lego1002/2026_TIRT/OminiBotHV-master/README.md

# OminiBotHV
This is diver about OminiBotHV( manufacturer : Circus Pi  ) , and how to use it.

<p align="center">
  
</p>

----
## Introduction

This repository contains driver , operation manual and communication.

firmware         :  [Bill](https://github.com/CIRCUSPi/OminiBotHV/blob/master/firmware/OminiBotCarStm32f1_v1.0.0.hex)

Communication    :  [OminiBotHV_v1.0.0](https://github.com/CIRCUSPi/OminiBotHV/blob/master/communication/OminibotHV_%E5%BA%95%E5%B1%A4%E9%80%9A%E8%A8%8A%E6%A0%BC%E5%BC%8F%E8%88%87%E5%B0%8F%E8%BB%8A%E9%81%8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)

Example          :  [Mecanum Wheel](https://github.com/CIRCUSPi/OminiBotHV/blob/master/example/OminiBot_HV_Meca.py)

Where to buy     :  [OminiBotHV](https://www.icshop.com.tw/products/368030200586)

----
## More information

You can visit our [official website](http://www.circuspi.com/) and [online shopping platform](https://www.icshop.com.tw/index.php) to search more information about us.

We provide many kinds of tutorial.

* For microcontroller , we have

> 1. [Arduino](http://www.circuspi.com/index.php/category/technical-article/arduino/) .
> 2. [linkit 7697](http://www.circuspi.com/index.php/category/technical-article/linkit/) .
> 3. [micro:bit](http://www.circuspi.com/index.php/category/technical-article/mbitbot-mini/) .

* For AI and Robot , we have 

> 1. [ROS](http://www.circuspi.com/index.php/category/technical-article/ros/).

----

## Development log

* 2023/07/20 (V1.0)
