lego1002/2026_TIRT/docs/OminibotHV_底層通訊格式與小車運動學_V1.0.0.pdf

# OminibotHV 底層通訊與小車運動學

### By Bill

2023/08/25

2

# OminibotHV -通訊封包格式(接收/回授)

3

# OminibotHV – 通訊封包格式定義

### - 數據回授封包格式

– 這裡還有㇐個地方需要注意，設定機器人硬體或是系統的原始資料，皆是浮 點型的資料（float），因為浮點型資料使用串口傳輸不方便，所以這四個資 料在發送之前先將浮點數放大㇐千倍（保留小數點後三位），再將放大後的 浮點數強制轉換成 short 型資料，最後在發送前將 short 型數據拆分成兩個

### 8 位元的數據。相應的，下位機端(STM32)在接收到資料後，需要將接收到

的數據兩個 8 位元資料合併後轉換為 short 型，在縮小㇐千倍來進行單位的 轉換。

### - STM32接收數據封包格式(14 char) – 系統配置

舉例說明 :
馬達方向定義只用到低八位(M4/M3/M2/M1) ，0為正轉，1為反轉。 EX : 0x02，M2反轉，其餘正轉
編碼器方向定義，同馬達方向定義(E4/E3/E2/E1) 。
EX:
4
數據 | Tx[0] | Tx[1] | Tx[2] | Tx[3] | Tx[4] | Tx[5] | Tx[6] | Tx[7] | Tx[8] | Tx[9] | Tx[10] | Tx[11] | Tx[12] | Tx[13]
內容 | 幀頭 0x7B ( ‘{’ ) | 命令 模式 0x23 ( ‘#’ ) | 馬達 方向 定義_ 高八 位 | 編碼 器方 向定 義_低 八位 | 馬達PWM最大 輸出值 | | 馬達PWM最小 輸出值 | | 編碼器PPR (pulse per rotation) | | 預留 | | BBC 校驗 位 | 幀尾 0x7D ( ‘}’ )
字節 大小 | char | char | Short | | Short (1 to 7199) | | Short (1 to 7199) | | Short | | Short (0) | | char | char
陣列 位置 | 0 | 1 | 2 | 3 | 4 | 5 | 6 | 7 | 8 | 9 | 10 | 11 | 12 | 13

# OminibotHV – 通訊封包格式定義(接收)

0 | 0 | 1 | 0

無單位量

### - STM32接收數據封包格式(14 bytes) – 小車尺寸參數配置

5

數據 | Tx[0] | Tx[1] | Tx[2] | Tx[3] | Tx[4] | Tx[5] | Tx[6] | Tx[7] | Tx[8] | Tx[9] | Tx[10] | Tx[11] | Tx[12] | Tx[13]
內容 | 幀頭 0x7B ( ‘{’ ) | 命令 模式 0x24 ( ‘$’ ) | 小車輪距 (Wheel Space) | | 小車軸距 (Axle Space) | | 馬達齒輪比 (Gear Ratio) | | 輪子直徑 (Wheel Diameter) | | 預留 | | BBC 校驗 位 | 幀尾 0x7D ( ‘}’ )
字節 大小 | char | char | Short | | Short | | Short | | Short | | Short | | char | char
陣列 位置 | 0 | 1 | 2 | 3 | 4 | 5 | 6 | 7 | 8 | 9 | 10 | 11 | 12 | 13

# OminibotHV – 通訊封包格式定義(接收)

單位:mm

### - STM32接收數據封包格式(14 bytes) – 小車PID參數配置

6

數據 | Tx[0] | Tx[1] | Tx[2] | Tx[3] | Tx[4] | Tx[5] | Tx[6] | Tx[7] | Tx[8] | Tx[9] | Tx[10] | Tx[11] | Tx[12] | Tx[13]
內容 | 幀頭 0x7B ( ‘{’ ) | 命令 模式 0x40 ( ‘@’ ) | POS_Kp (需要放大100 倍) | | POS_Ki (需要放大100 倍) | | POS_Kd (需要放大100 倍) | | VEL_Kp (需要放大100 倍) | | VEL_Ki (需要放大100 倍) | | BBC 校驗 位 | 幀尾 0x7D ( ‘}’ )
字節 大小 | char | char | Short | | Short | | Short | | Short | | Short | | char | char
陣列 位置 | 0 | 1 | 2 | 3 | 4 | 5 | 6 | 7 | 8 | 9 | 10 | 11 | 12 | 13

# OminibotHV – 通訊封包格式定義(接收)

單位:放大100倍 | 單位:放大100倍 | 單位:放大100倍

- 舉例KUBOT參數設定說明(最大速度只有 0.368 m/s) : – mobptr-> MotorDir=0x00; – mobptr-> EncoderDir =0x02; – mobptr->Divisor_Mode = 4; – mobptr->GearRatio = 139; – mobptr->WheelEncoderPrecision = Divisor_Mode * 973; – mobptr->WheelDiameter = 0.160f; – mobptr->TrackSpacing = 0.240f; – mobptr->AxleSpacing = 0.0f; – mobptr->PWM_DutyCy_Max = 7056; //set pwm max duty cycle to 98%
– mobptr->PWM_DutyCy_Min = 1440; //set pwm min duty cycle to 20% | 7

# OminibotHV – 通訊封包格式定義(接收)

- 舉例KUBOT參數設定說明(最大速度只有 0.368 m/s) : – mobptr->pid_pos[0] = 30.0f; | | //位置控制參數KP
– mobptr->pid_pos[1] = 10.5f; | //位置控制參數KI – mobptr->pid_pos[2] = 0.0f; | //位置控制參數KD
– mobptr->pid_vel[0] = 30.5f; | | //速度控制參數KP
– mobptr->pid_vel[1] = 10.5f; | //速度控制參數KI –

8

# OminibotHV – 通訊封包格式定義(接收)

- 舉例小車系統配置 : – 7B 23 00 02 1B 90 05 A0 03 CD 00 00 BA 7D( { # 0 2 7056 1440 973 0 } )
- 舉例小車尺寸參數配置 : – 7B 24 00 F0 00 00 00 8B 00 A0 00 00 84 7D( { $ 240 0 139 160 0 B } )
- 舉例小車PID參數配置: – 7B 40 0B B8 04 1A 00 00 0B B8 04 1A 3B 7D( { @ 3000 1050 0 3000 1050 B } ) – ( { @ 6000 1050 0 6000 1050 B } )

9

# OminibotHV – 通訊封包格式定義(接收)

### - STM32接收數據封包格式- 運動控制配置

數據 | Tx[0] | Tx[1] | Tx[2] | Tx[3] | Tx[4] | Tx[5] | Tx[6] | Tx[7] | Tx[8] | Tx[9] | Tx[10] | Tx[11] | Tx[12] | Tx[13]
內容 | 幀頭 0x7B ( ‘{’ ) | 命令模 式 ( ‘%’ ‘&’ ) | 控制模 式(停 止/位 置/速 度) | 小車型 別 | X方向 速度或 A馬達 速率_ 高八位 | X方向 速度或 A馬達 速率_ 低八位 | Y方向 速度或 B馬達 速率_ 高八位 | Y方向 速度或 B馬達 速率_ 低八位 | Z方向 速度或 C馬達 速率_ 高八位 | Z方向 速度或 C馬達 速率_ 低八位 | W方向 速度或 D馬達 速率_ 高八位 | W方向 速度或 D馬達 速率_ 低八位 | BBC 校 驗位 | 幀尾 0x7D ( ‘}’ )
字節 大小 | char | char | char | char | short | | short | | short | | short | | char | char
陣列 位置 | 0 | 1 | 2 | 3 | 4 | 5 | 6 | 7 | 8 | 9 | 10 | 11 | 12 | 13

10

# OminibotHV – 通訊封包格式定義(接收)

單位:mm/s或是1000*rad/s

### - STM32接收數據封包格式 – 命令模式選擇(由上層的ROS決定) – 0x23(#) ：小車運動系統配置

– 0x24 ($) ：小車運動學參數配置
– 0x25(%) ：小車速度控制模式(Vx, Vy, Vz) – 0x26 (&) ：小車各馬達獨立控制 with 編碼器(M1, M2, M3, M4) – 0x40 (@) ：小車PID參數
- STM32接收數據封包格式 – 小車型別(由上層的ROS決定) – 0x02：TWODDMOBILE (ex: kubot) – 0x03：OMINIMOBILE (ex: 三輪智慧機器人) – 0x04：MECANUMMOBILE(ex: rosky2, racingrat) – 0x05：FOURWDMOBILE(rosky1)

11

STM32接收數據封包格式 - 控制模式
FORCESTOP ： 0 (強制停止)
POSITIONCTRL ： 1 (位置控制)
VELOCITYCTRL ： 2 (速度控制)

# OminibotHV – 通訊封包格式定義(接收)

- 舉例說明 : – X軸，+200mm/s | ，7B 25 02 05 00 C8 00 00 00 00 00 00 91 7D
– 停止，0mm/s | ，7B 25 02 05 00 00 00 00 00 00 00 00 59 7D
– X軸，-200mm/s | ，7B 25 02 05 FF 38 00 00 00 00 00 00 9E 7D
– 馬達M1，+200mm/s，7B 26 02 05 00 C8 00 00 00 00 00 00 92 7D – 馬達M4，-200mm/s ，7B 26 02 05 00 00 00 00 00 00 FF 38 9D 7D

12

# OminibotHV – 通訊封包格式定義(接收)

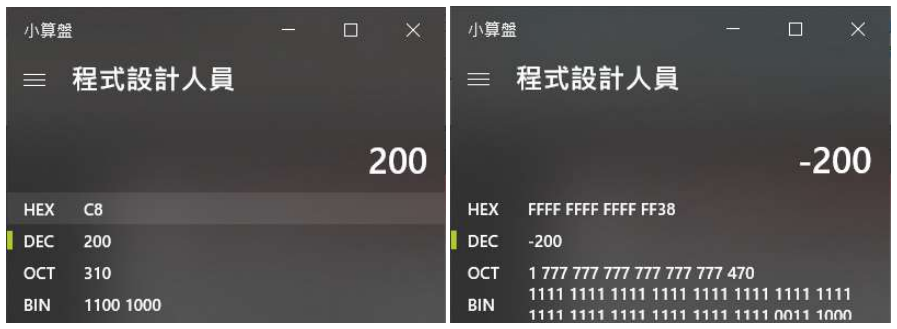
[picture p3: figure]

Block Check Character Calculator

車體ROSKY1做
速度控制

車體ROSKY1做
馬達速度控制

- 舉例說明 : – X軸，+200mm/s | ，7B 25 02 02 00 C8 00 00 00 00 00 00 96 7D
– 停止，0mm/s | ，7B 25 02 02 00 00 00 00 00 00 00 00 5E 7D
– X軸，-200mm/s | ，7B 25 02 02 FF 38 00 00 00 00 00 00 99 7D
– 馬達M1/M2，+100mm/s，7B 26 02 02 00 64 00 64 00 00 00 00 5D 7D – 馬達M1/M2 ，-200mm/s ，7B 26 02 02 FF 38 FF 38 00 00 00 00 5D 7D

13

# OminibotHV – 通訊封包格式定義(接收)

Block Check Character Calculator

KUBOT車體做
線性速度控制

KUBOT馬達做
旋轉速度控制

14

# OminibotHV – 通訊封包格式定義(回授)

### - STM32回授數據封包格式 – 命令模式選擇(由上層的ROS決定) – 0x33(‘3’) ：回授小車運動系統配置

– 0x34 (‘4’) ：回授小車運動學參數配置
– 0x35(‘5’) ：回授小車速度控制模式(Vx, Vy, Vz) – 0x36 (‘6’) ：回授小車各馬達獨立控制 with 編碼器(M1, M2, M3, M4) – 0x50 (‘P’) ：回授小車PID參數

### - STM32回授數據封包格式- 速度控制配置

數據 | Tx[0] | Tx[1] | Tx[2] | Tx[3] | Tx[4] | Tx[5] | Tx[6] | Tx[7] | Tx[8] | Tx[9] | Tx[10] | Tx[11] | Tx[12] | Tx[13]
內容 | 幀頭 0x7B ( ‘{’ ) | 命令模 式 0x35/0 x36 ( ‘5’ ‘6’) | 控制模 式(位 置/速 度/停 止) | 小車型 別 | X方向 速度或 A馬達 速率_ 高八位 | X方向 速度或 A馬達 速率_ 低八位 | Y方向 速度或 B馬達 速率_ 高八位 | Y方向 速度或 B馬達 速率_ 低八位 | Z方向 速度或 C馬達 速率_ 高八位 | Z方向 速度或 C馬達 速率_ 低八位 | W方向 速度或 D馬達 速率_ 高八位 | W方向 速度或 D馬達 速率_ 低八位 | BBC 校 驗位 | 幀尾 0x7D ( ‘}’ )
字節 大小 | char | char | char | char | short | | short | | short | | short | | char | char
陣列 位置 | 0 | 1 | 2 | 3 | 4 | 5 | 6 | 7 | 8 | 9 | 10 | 11 | 12 | 13

15

# OminibotHV – 通訊封包格式定義(回授)

單位:mm/s或是1000*rad/s

### - STM32回授數據封包格式(14 char) – 系統配置

16

數據 | Tx[0] | Tx[1] | Tx[2] | Tx[3] | Tx[4] | Tx[5] | Tx[6] | Tx[7] | Tx[8] | Tx[9] | Tx[10] | Tx[11] | Tx[12] | Tx[13]
內容 | 幀頭 0x7B ( ‘{’ ) | 命令 模式 0x33 ( ‘3’ ) | 馬達 方向 定義_ 高八 位 | 編碼 器方 向定 義_低 八位 | 馬達PWM最大 輸出值 | | 馬達PWM最小 輸出值 | | 編碼器PPR (pulse per rotation) | | 預留 | | BBC 校驗 位 | 幀尾 0x7D ( ‘}’ )
字節 大小 | char | char | Short | | Short (max to 7199) | | Short (min to 720) | | Short | | Short (0) | | char | char
陣列 位置 | 0 | 1 | 2 | 3 | 4 | 5 | 6 | 7 | 8 | 9 | 10 | 11 | 12 | 13

# OminibotHV – 通訊封包格式定義(回授)

0 | 0 | 1 | 0

無單位量

### - STM32回授數據封包格式(14 bytes) – 小車尺寸參數配置

17

數據 | Tx[0] | Tx[1] | Tx[2] | Tx[3] | Tx[4] | Tx[5] | Tx[6] | Tx[7] | Tx[8] | Tx[9] | Tx[10] | Tx[11] | Tx[12] | Tx[13]
內容 | 幀頭 0x7B ( ‘{’ ) | 命令 模式 0x34 ( ‘4’ ) | 小車輪距 (Wheel Space) | | 小車軸距 (Axle Space) | | 馬達齒輪比 (Gear Ratio) | | 輪子直徑 (Wheel Diameter) | | 預留 | | BBC 校驗 位 | 幀尾 0x7D ( ‘}’ )
字節 大小 | char | char | Short | | Short | | Short | | Short | | Short | | char | char
陣列 位置 | 0 | 1 | 2 | 3 | 4 | 5 | 6 | 7 | 8 | 9 | 10 | 11 | 12 | 13

# OminibotHV – 通訊封包格式定義(回授)

單位:mm

### - STM32回授數據封包格式(14 bytes) – 小車PID參數配置

18

數據 | Tx[0] | Tx[1] | Tx[2] | Tx[3] | Tx[4] | Tx[5] | Tx[6] | Tx[7] | Tx[8] | Tx[9] | Tx[10] | Tx[11] | Tx[12] | Tx[13]
內容 | 幀頭 0x7B ( ‘{’ ) | 命令 模式 0x50 ( ‘P’ ) | POS_Kp (需要放大100 倍) | | POS_Ki (需要放大100 倍) | | POS_Kd (需要放大100 倍) | | VEL_Kp (需要放大100 倍) | | VEL_Ki (需要放大100 倍) | | BBC 校驗 位 | 幀尾 0x7D ( ‘}’ )
字節 大小 | char | char | Short | | Short | | Short | | Short | | Short | | char | char
陣列 位置 | 0 | 1 | 2 | 3 | 4 | 5 | 6 | 7 | 8 | 9 | 10 | 11 | 12 | 13

# OminibotHV – 通訊封包格式定義(回授)

單位:放大100倍 | 單位:放大100倍 | 單位:放大100倍

- 舉例讀回小車系統配置 : – 7B 33 00 00 00 00 00 00 00 00 00 00 48 7D( { 3 0 0 0 0 0 B } )
- 舉例讀回小車尺寸參數配置 : – 7B 34 00 00 00 00 00 00 00 00 00 00 4F 7D( { 4 0 0 0 0 0 B } )
- 舉例讀回小車PID參數配置: – 7B 50 00 00 00 00 00 00 00 00 00 00 2B 7D( { P 0 0 0 0 0 B } )

19

# OminibotHV – 通訊封包格式定義(回授)

數據 | Tx[0] | Tx[1] | Tx[2] | Tx[3] | Tx[4] | Tx[5] | Tx[6] | Tx[7] | Tx[8] | Tx[9] | Tx[10] | Tx[11] | Tx[12] | Tx[13]
內容 | 幀頭 0x7B | 預留 | X方向 速度_ 高八位 | X方向 速度_ 低八位 | Y方向 速度_ 高八位 | Y方向 速度_ 低八位 | Z方向 速度_ 高八位 | Z方向 速度_ 低八位 | X軸加 速度_ 高八位 | X軸加 速度_ 低八位 | Y軸加 速度_ 高八位 | Y軸加 速度_ 低八位 | Z軸加 速度_ 高八位 | Z軸加 速度_ 低八位
字節 大小 | char | char | short | | short | | short | | short | | short | | short
陣列 位置 | 0 | 1 | 2 | 3 | 4 | 5 | 6 | 7 | 8 | 9 | 10 | 11 | 12 | 13

### - STM32回授數據封包格式(mm/s & 放大1000)

20

# OminibotHV – 通訊封包格式定義(回授)

### - STM32回授數據封包格式(放大1000)

21

# OminibotHV – 通訊封包格式定義(回授)

數據 | Tx[14] | Tx[15] | Tx[16] | Tx[17] | Tx[18] | Tx[19] | Tx[20] | Tx[21] | Tx[22] | Tx[23] | Tx[24] | Tx[25] | Tx[26] | Tx[27]
內容 | X方向 角速度 高八位 | X方向 角速度 低八位 | Y方向 角速度 高八位 | Y方向 角速度 低八位 | Z方向 角速度 高八位 | Z方向 角速度 低八位 | 四元數 W方向 高八位 | 四元數 W方向 低八位 | 四元數 X方向 高八位 | 四元數 X方向 低八位 | 四元數 Y方向 高八位 | 四元數 Y方向 低八位 | 四元數 Z方向 高八位 | 四元數 Z方向 低八位
字節 大小 | short | | short | | short | | short | | short | | short | | short
陣列 位置 | 14 | 15 | 16 | 17 | 18 | 19 | 20 | 21 | 22 | 23 | 24 | 25 | 26 | 27

- STM32回授數據封包格式

– 這裡還有㇐個地方需要注意，機器人 XYZ 三軸線性速度、加速度 計、角速度計、四元數方位值以及電池電壓的原始資料是浮點型的 資料（float），因為浮點型資料使用串口傳輸不方便，所以這四 個資料在發送之前先將浮點數放大㇐千倍（保留小數點後三位）， 再將放大後的浮點數強制轉換成 short 型資料，最後在發送前將 short 型數據拆分成兩個 8 位元的數據。相應的，上位機端在接收 到資料後，需要將接收到的數據兩個 8 位元資料合併後轉換為 short 型，在縮小㇐千倍來進行單位的轉換。

22

# OminibotHV – 通訊封包格式定義(回授)

數據 | Tx[28] | Tx[29] | Tx[30] | Tx[31]
內容 | 電壓_ 高八位 | 電壓_ 低八位 | BBC 校驗 位 | 幀尾 0x7D
字節 大小 | short | | char | char
陣列 位置 | 28 | 29 | 30 | 31

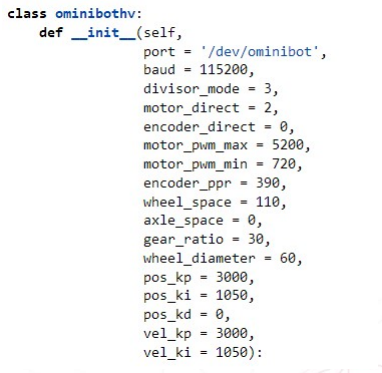
[picture p4: figure]
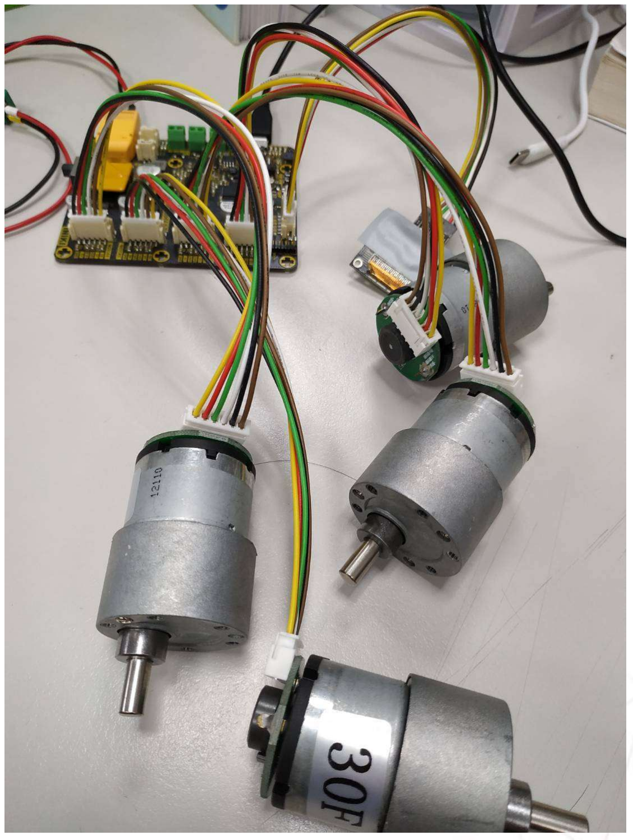
[picture p5: figure]

### - 確認硬體接線和開關

– PWR_ON(開啟電源) – MODE_ON(OLED才會顯示)

### - 參數設定

– 四輪小車系統配置

### - 觀察OLED

– 四輪小車運動控制

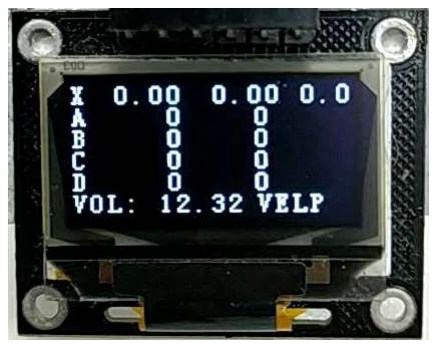
[picture p6: figure]

23

# OminibotHV板 – QC功能測試範例程式(4輪小車)

預設+12V

24

# OminibotHV板 –QC功能測試範例程式(4輪小車)

### - 第㇐步，依序執行四輪小車系統配置 :

1) 7B 23 05 00 10 00 02 D0 01 86 00 00 18 7D( { # 0 2 4096 720 390 0 } )
2) 7B 24 00 F0 00 00 00 8B 00 A0 00 00 84 7D( { $ 240 0 139 160 0 B } )
3) 7B 40 0B B8 04 1A 00 00 0B B8 04 1A 3B 7D( { @ 3000 1050 0 3000 1050 B } )

### - 第二步，四輪小車運動控制 :

1) X軸，+200mm/s | ，7B 25 02 05 00 C8 00 00 00 00 00 00 91 7D
2) 停止，0mm/s | ，7B 25 02 05 00 00 00 00 00 00 00 00 59 7D
3) X軸，-200mm/s | ，7B 25 02 05 FF 38 00 00 00 00 00 00 9E 7D
4) 馬達M1，+200mm/s，7B 26 02 05 00 C8 00 00 00 00 00 00 92 7D
5) 馬達M2，+200mm/s，7B 26 02 05 00 00 00 C8 00 00 00 00 92 7D
6) 馬達M3，+200mm/s，7B 26 02 05 00 00 00 00 00 C8 00 00 92 7D
7) 馬達M4，+200mm/s，7B 26 02 05 00 00 00 00 00 00 00 C8 92 7D

25

# OminibotHV -FLASH讀寫控制

### - FLASH存儲起始位址 : 0x0801FC00

26

# Stm32範例程式(九) – FLASH讀寫控制

數 據 | [0] | [1] | [2] | [3] | [4] | [5] | [6] | [7] | [8] | [9] | [10] | [11]
內 容 | 小車 型別 (1~4) | 控制 模式 (1~2) | 位置 PID_P 值 | 位置 PID_I 值 | 位置 PID_ D值 | 速度 PID_P 值 | 速度 PID_I 值 | 速度 PID_ D值 | PWM _最 大值 | PWM _最 小值 | 預留 | 預留
字 節 大 小 | word | word | word | word | word | word | word | word | word | word | word | word
陣 列 位 置 | 0 | 1 | 2 | 3 | 4 | 5 | 6 | 7 | 8 | 9 | 10 | 11

27

# OminibotHV -小車正/逆運動學

# OminibotHV - 小車正/逆運動學(兩輪差速)

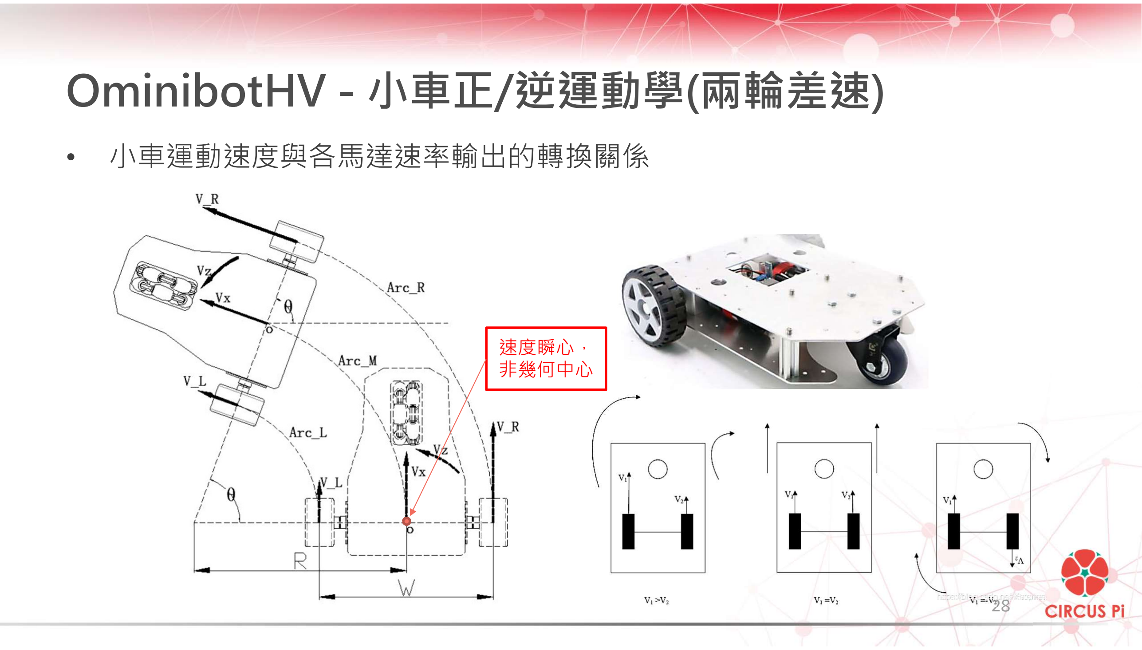
[picture p7: page 28]

### - 小車運動速度與各馬達速率輸出的轉換關係

28

速度瞬心，
非幾何中心

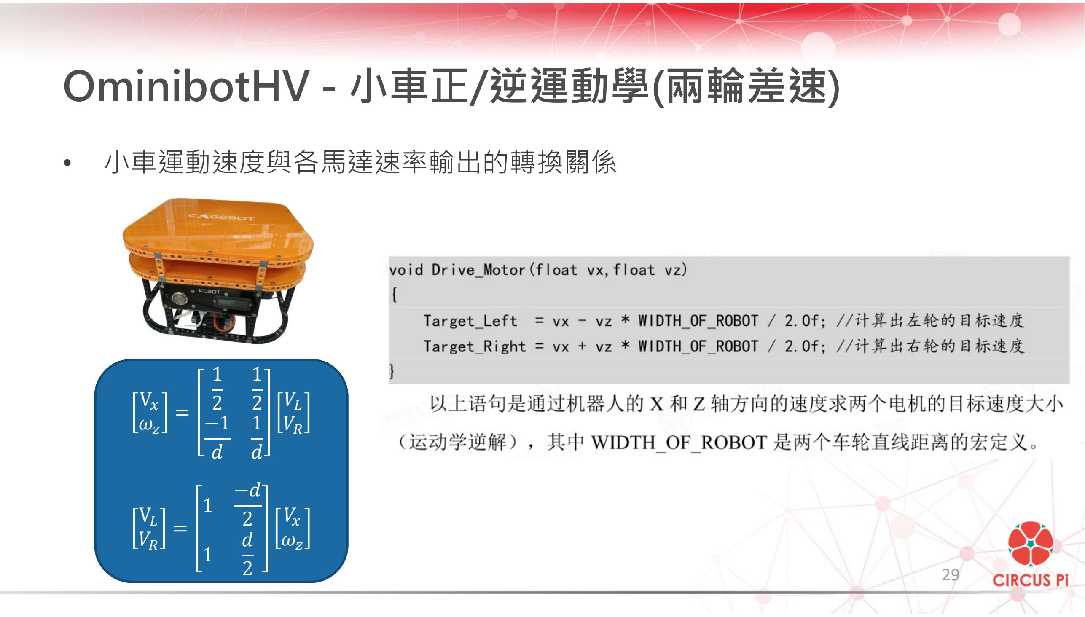
[picture p8: figure]
• 小車運動速度與各馬達速率輸出的轉換關係; OminibotHV - 小車正/逆運動學(兩輪差速)

# OminibotHV - 小車正/逆運動學(四輪差速)

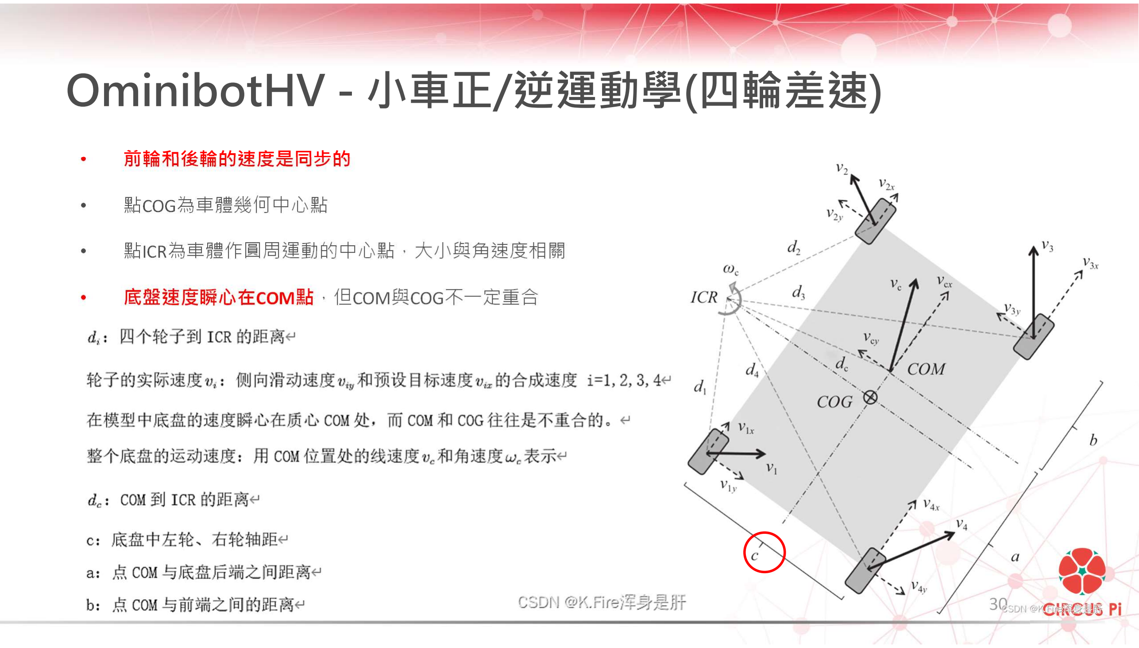
[picture p9: page 30]

- 前輪和後輪的速度是同步的
- 點COG為車體幾何中心點
- 點ICR為車體作圓周運動的中心點，大小與角速度相關
- 底盤速度瞬心在COM點，但COM與COG不㇐定重合

30

# OminibotHV - 小車正/逆運動學(四輪差速)

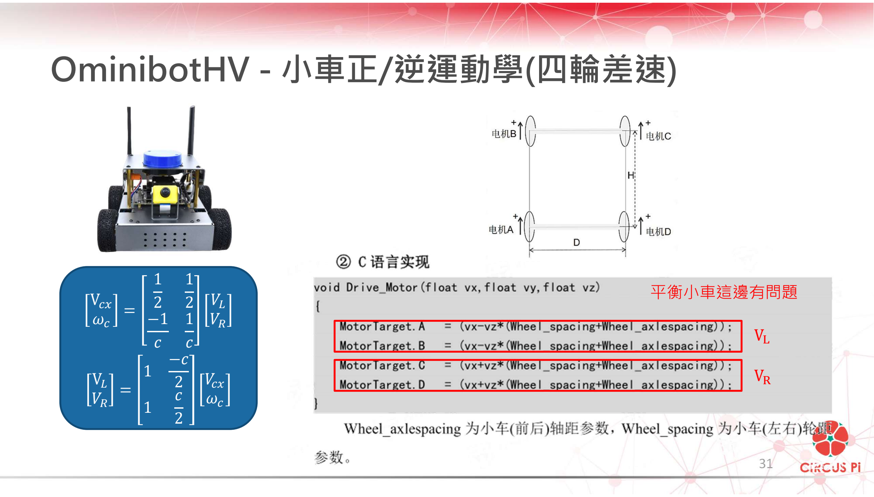
[picture p10: page 31]

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
平衡小車這邊有問題

# OminibotHV - 小車正/逆運動學(麥克拉姆輪)

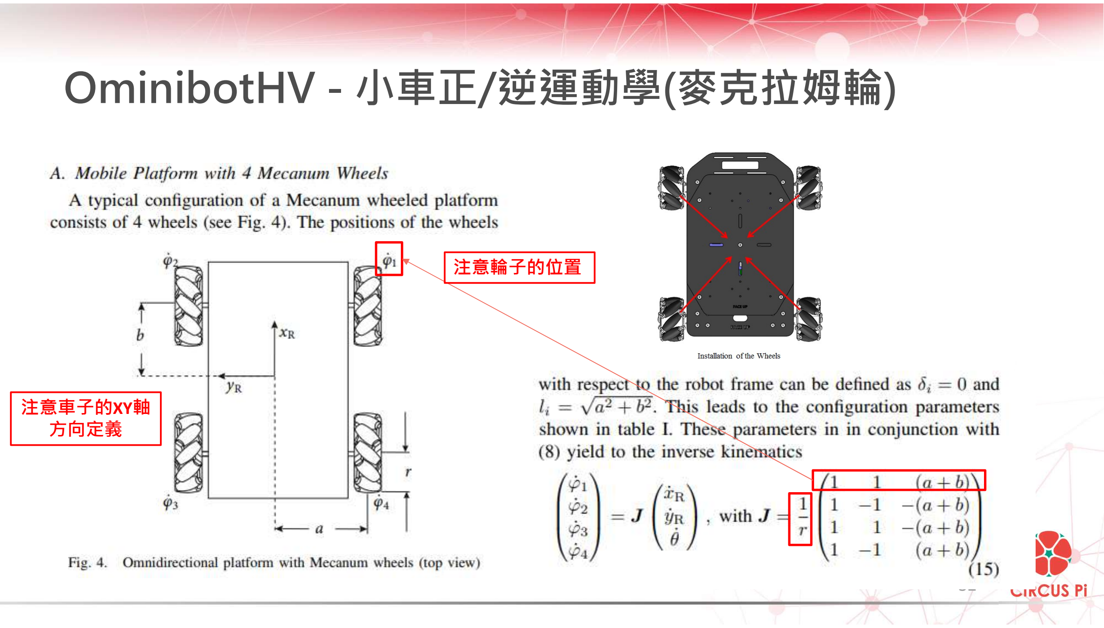
[picture p11: page 32]

32

注意輪子的位置

注意車子的XY軸
方向定義

# OminibotHV - 小車正/逆運動學(麥克拉姆輪)

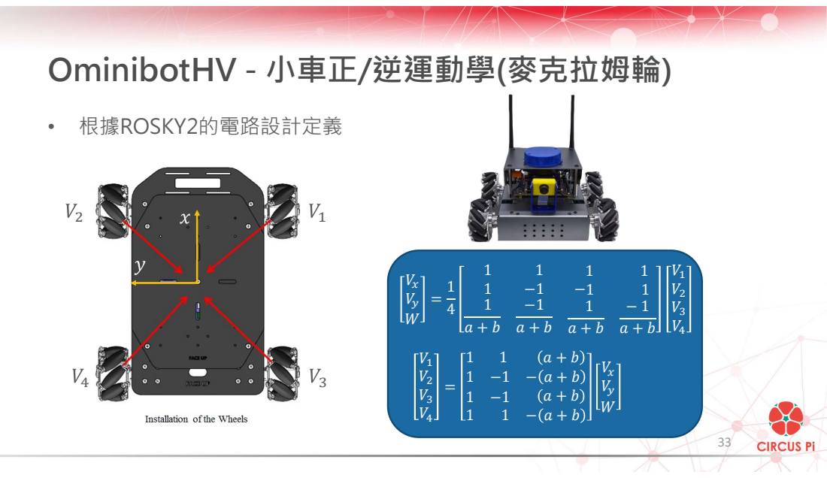
[picture p12: page 33]
• 根據ROSKY2的電路設計定義

# OminibotHV - 小車正/逆運動學(全向輪)

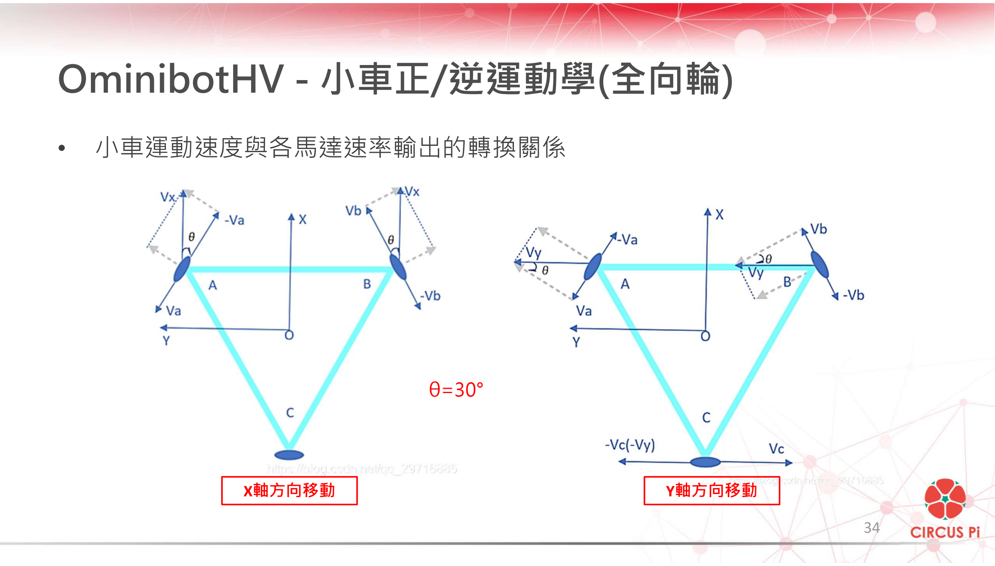
[picture p13: page 34]

### - 小車運動速度與各馬達速率輸出的轉換關係

34

X軸方向移動 | Y軸方向移動

θ=30°

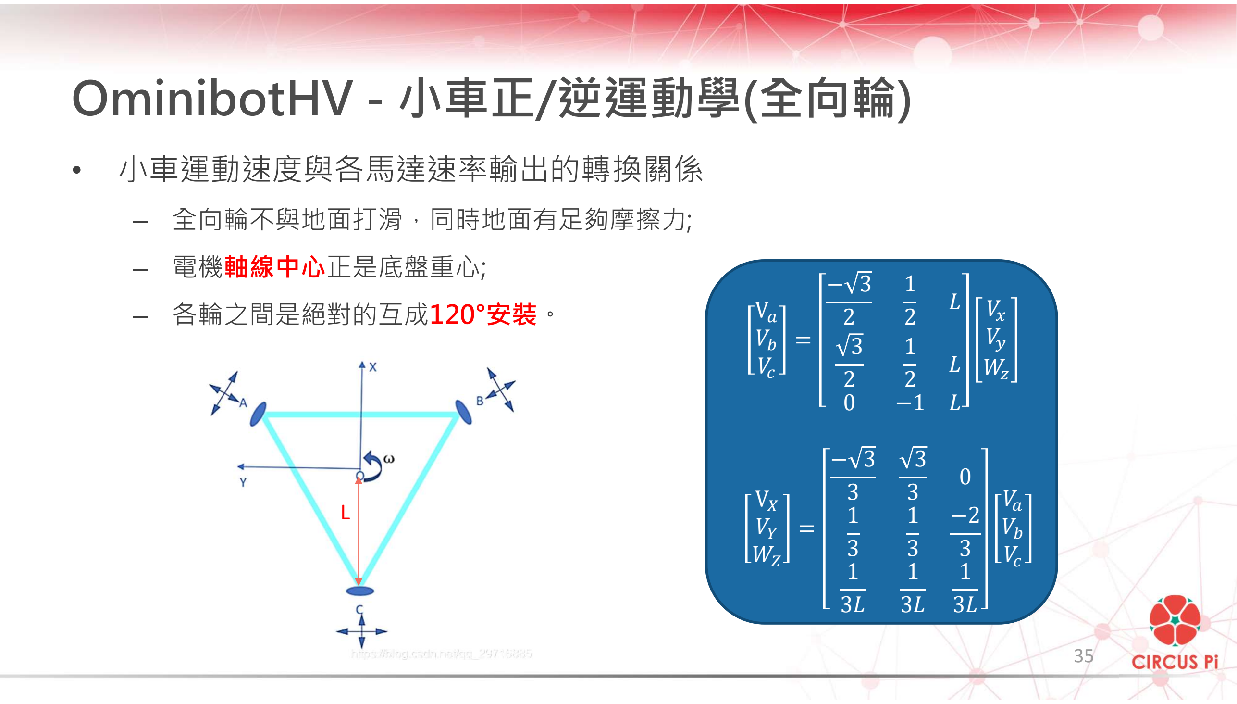
[picture p14: figure]
• 小車運動速度與各馬達速率輸出的轉換關係; OminibotHV - 小車正/逆運動學(全向輪)

– 全向輪不與地面打滑，同時地面有足夠摩擦力; – 電機軸線中心正是底盤重心; – 各輪之間是絕對的互成120°安裝。
