lego1002/2026_TIRT/notes/README.md

# 文件索引

## 比賽

| 文件 | 內容 |
|---|---|
| [比賽紀錄](../race_logs/2026-11-07/README.md) | 2026-11-07 的時間軸、數據和判斷 |
| [比賽現場解題手冊](../race_logs/2026-11-07/比賽現場解題手冊.md) | 遇到問題時照著做的步驟 |
| [比賽規則](../docs/2026TIRT-迷宮機器人挑戰賽.pdf) | 官方規則 PDF |

## 建圖與導航

| 文件 | 內容 |
|---|---|
| [SLAM_learning_note.md](SLAM_learning_note.md) | SLAM 入門、實測問題與校正步驟 |
| [nav2_tuning.md](nav2_tuning.md) | Nav2 症狀對照和調參方法 |
| [nav_runs/](nav_runs/) | 2026-10-10 兩趟導航的錄檔 |

## 操作與連線

| 文件 | 內容 |
|---|---|
| [command_note.md](command_note.md) | 建圖流程指令小抄（雙機模式時期） |
| [雙機RViz連線.md](雙機RViz連線.md) | 雙機模式的完整操作手冊 |
| [networkplan.md](networkplan.md) | 比賽現場自帶 WiFi 的規劃 |
| [0721_net_issue_plan.md](0721_net_issue_plan.md) | 掉 scan 問題的網路除錯紀錄 |

## 機構與硬體

| 文件 | 內容 |
|---|---|
| [urdf閱讀方法.md](urdf閱讀方法.md) | URDF 檢視方法和待辦 |
| [控制板通訊協定](../docs/OminibotHV_底層通訊格式與小車運動學_V1.0.0.pdf) | OminiBotHV 序列埠格式和運動學 |

## 模擬

| 文件 | 內容 |
|---|---|
| [sim/README.md](../sim/README.md) | 模擬器使用說明 |
| [sim/faults.md](../sim/faults.md) | 重現這台車實際發生過的故障 |

## 實測資料

| 路徑 | 內容 |
|---|---|
| [field_data/2026-07_odom_straight/](field_data/2026-07_odom_straight/) | 2026 年 7 月直線里程測試 log |

> 較舊的筆記可能描述當時的做法。目前的操作方式以根目錄 [README](../README.md) 為準，技術細節以 [CLAUDE.md](../CLAUDE.md) 為準。
