lego1002/2026_TIRT/race_logs/2026-11-07/README.md

# 2026 TIRT 比賽紀錄（2026-11-07）

這個資料夾保存比賽當天 10:40～11:00 的指令、系統訊息和分析，方便之後回頭研究。

- **現場遇到問題怎麼辦：** 看 [`比賽現場解題手冊.md`](比賽現場解題手冊.md)
- **只想看發生順序：** 看下面的「時間軸」，完整版在 [`timeline_auto.txt`](timeline_auto.txt)

## 一句話結論

場上 3 個導航目標都沒有到達。地圖、供電和序列埠看起來正常；主要症狀是車子跑到中途開始**反覆左右移動**，只前進一點點。
**根本原因還沒有定論**，因為這次沒有錄到車子的位置和速度指令。

## 操作者的現場觀察

這些是操作者親眼看到的，log 裡看不出來，所以記在這裡：

- 用 `a/d` 原地轉向，地圖會飄；不用 `a/d`，就算邊打滑邊建圖，IMU 也抓得準，牆不會跑掉。
- 場地本身會打滑。
- 車子跑到中途開始抖，但 Nav2 有規劃出路徑，也沒有吃到安全區。
- 賽後回想：車子只跑一點點，**輪子沒有在空轉，而是反覆左右移動**。
- 導航前定位已經顯示 OK。
- 在租屋處建圖都比今天慢，導航速度相同，卻跑得很順。
- 在租屋處，比賽和房間兩種安全圈參數都用過，差別只有撞牆多寡。
- 最嚴重的問題：車子走不到三個導航點就開始出問題。

## 時間軸

選單順序來自 `operator/menu_session.txt`，時間來自 ROS log。

| 時間 | 操作 | 系統回應 |
|---|---|---|
| 10:40 | 選單 `1` 建圖、`2` 遙控 | 線速度在 0.16～0.22 m/s 之間調整 |
| 10:44:46 | 選單 `0` 全關 | **第 1 次建圖沒有存圖** |
| 10:45 | 選單 `1`、`2` | |
| 10:47:52 | 選單 `0` 全關 | **第 2 次建圖沒有存圖** |
| 10:49 | 選單 `1`、`2`、`2` | 轉向速度從 0.8 降到 0.58 rad/s |
| 10:53:21 | 選單 `3` 存圖 | 地圖 `rzce` 存檔成功 |
| 10:53:28 | 選單 `0` 全關 | |
| 10:54:13 | 選單 `4` 導航（`rzce`） | 啟動時一次序列埠警告（8.5%），之後沒再出現 |
| 10:55:11 | 送出 2 個航點，第一個是 (3.05, -1.95) | 開始走 |
| 10:55:32 | 手動取消目標 | `Goal canceled` |
| 10:56:00 | 選單 `4` 重開導航，底盤沒關 | 舊導航 5 秒內沒結束，被強制關閉 |
| 10:56:20 | 新導航啟動中 | **卡住 64 秒**，一直沒有載入節點 |
| 10:57:24 | 選單 `0` 全關 | `Abandoning wait for ... load_node` |
| 10:57:46 | 選單 `4` 導航（`rzce`） | 正常啟動 |
| 10:58:07 | 目標 (3.16, -2.05) | 開始走 |
| 10:58:32 | | 第 1 次 `Failed to make progress` |
| 10:58:40 | 換目標 (2.77, -4.08) | 此時只走了約 0.67 m（AMCL 位置） |
| 10:58:47～10:59:17 | | 再 3 次 `Failed to make progress` |
| 10:59:17 | | 自動原地轉 90° 救援 |
| 10:59:30～10:59:50 | | 規劃失敗 10 次；後退救援報 `Collision Ahead`；再轉一次 90° |
| 10:59:50 | | `Goal failed` |
| 11:00:44 | 選單 `0` 全關 | 光達馬達正常停止 |

## 數據比較

導航參數從 2026-10-27 之後沒有改過。

| | 11/2＋11/6（租屋處） | 11/7（比賽） |
|---|---|---|
| 到達目標 | 15 / 15 | 0 / 3 |
| `Failed to make progress` | 0 次 | 4 次 |
| 單趟距離 | 最遠 2.63 m | 3.8～4.3 m |
| 地圖可走面積 | 約 4 m²（11/6 的圖） | 約 14 m² |

## 判斷

### 看起來正常

- **地圖 `rzce`：** 牆大致互相垂直，沒有彎掉，大小約 4.0×4.1 m；部分內牆有雙線。
- **供電：** 賽後 `get_throttled` 為 `0x0`，代表這次開機以來沒有欠壓或過熱旗標。
- **序列埠：** 只有一次警告，`uart overrun=0`，也沒有 `feedback gap` 警告。
- **CPU：** 控制迴圈只漏了 2 次。
- **地圖幾何：** 3 個目標在靜態地圖上都走得到，最窄處約 31 公分寬。

### 推測（尚未驗證）

| 嫌疑 | 根據 | 還缺什麼 |
|---|---|---|
| 控制器左右修正過頭 | 反覆左右移動，移動範圍若沒超過 10 cm，就正好符合連續 `Failed to make progress`；`PathDist` 權重 32，路徑每秒更新一次 | 錄 `/cmd_vel`，看橫移方向是否來回翻轉 |
| 定位左右跳動，控制器跟著追 | 場地大、牆遠，和在家不同；AMCL 每 5 cm 就更新一次，這條線在 `notes/nav2_tuning.md` 也還沒查 | 同時錄 AMCL 位置和里程，比對跳動 |
| 橫移在滑的地面上衝過頭 | 在家量過橫移 1 m 實際走 1.074 m；同參數在家不會左右來回 | 改小橫移速度或加減速重跑 |
| 輪速頂到上限 | 合成需求最高約 0.54 m/s，實測上限約 0.44 m/s | 同一套參數在家沒抖，所以嫌疑較小 |
| 原地轉時光達掃描變形，地圖和定位變差 | 0.72 rad/s 時，掃一圈車頭轉約 4°，3 m 外偏約 21 cm；和不用 a/d 就穩定的觀察相符 | 錄掃描資料比對 |
| 規劃失敗是因為車太貼牆或定位偏掉 | 靜態地圖走得到，後退時卻報 `Collision Ahead` | 失敗當下的車子位置 |

安全圈不太像是抖動的主因：操作者在家兩種都用過，差別只有撞牆多寡。

### 已確認的軟體問題

底盤開著、在筆電 RViz 模式下原地重開導航，曾卡住 64 秒。全關再開就恢復。卡住的原因還沒查。

## 這份紀錄缺什麼

下次要分析得更準，最缺的是前兩項：

1. **車子位置和速度指令：** 這次沒有開 `tools/nav_record.py`。
2. **實際畫面：** 沒有拍車子的影片，也沒有 RViz 截圖，左右移動的幅度和頻率只能靠回憶。
3. **視窗畫面：** `tirt` tmux 各視窗的輸出沒有另外存，只留下 ROS log。
4. **正式成績：** 這裡沒有記錄名次和官方判定。

## 資料夾內容

| 路徑 | 內容 |
|---|---|
| `timeline_auto.txt` | 從 ROS log 抽出的重要事件，依時間排序 |
| `operator/menu_session.txt` | 選單畫面完整紀錄（按了什麼、看到什麼） |
| `operator/shell_commands.txt` | 選單送進 tmux 的指令（shell 歷史沒有時間戳） |
| `ros_log/` | 當天所有 ROS 節點和 launch 的原始 log |
| `params/` | 比賽版設定檔；`resolved_at_race/` 是實際載入的參數 |
| `map/` | 比賽地圖 `rzce` 和放大 3 倍的圖片 |
| `code/` | 當時的 commit，以及尚未 commit 的 teleop 緩加速修改 |
| `system/` | 核心和 OLED 服務的 log、賽後電源狀態 |

### 讀 log 時要注意

- `system/kernel_and_oled.txt` 開頭的日期是 10-12，因為 Pi 沒有電池時鐘，開機時時間還沒校正。10:39 左右校正之後才準。
- 這個倉庫是公開的，所以 MAC、區網和 Tailscale IP、光達序號已經遮掉，也沒有放入網路服務的系統 log。除此之外，ROS log 內容保持原樣。
