lego1002/2026_TIRT/THIRD_PARTY_NOTICES.md

# 第三方內容說明

根目錄的 [`LICENSE`](LICENSE)（BSD-3-Clause）適用於本專案自己撰寫的內容。下列內容屬於各自的權利人，或來源的授權尚未確認，**不在** BSD-3-Clause 的授權範圍內。

| 路徑 | 來源 | 狀態 |
|---|---|---|
| `OminiBotHV-master/` | CircusPi 的 OminiBotHV 範例、韌體和文件 | 未附授權聲明 |
| `ominibot_driver/ominibot_driver/ominibot_hv.py` | 通訊協定類別整理自上述廠商範例，之後另有修改 | 來自廠商範例的部分，授權尚未確認 |
| `docs/2026TIRT-迷宮機器人挑戰賽.pdf` | 比賽主辦單位 | 屬於主辦單位 |
| `docs/OminibotHV_底層通訊格式與小車運動學_V1.0.0.pdf` | CircusPi | 屬於廠商 |
| `CAD_files/step/Lego Technic Beam - 6898072/` | Thingiverse 作者 chriscummings100 | 見該資料夾的 `LICENSE.txt` |
| `CAD_files/` 裡的其他市售零件參考模型（麥克納姆輪、N20 馬達、Raspberry Pi、光達等） | 各自的作者或廠商 | 來源和授權尚未逐一確認 |
| `car_assemble_description/meshes/` | 由包含上述零件的組合件匯出 | 其中的第三方幾何依原來源為準 |
| `car_assemble_description/rviz/view_nav2.rviz` | 修改自 `nav2_bringup` 的 `nav2_default_view.rviz` | 依 Nav2 上游授權 |
| `config/nav2_params.yaml` | 以 `nav2_bringup` 的預設參數為基礎 | 依 Nav2 上游授權 |
| `config/mapper_params_online_async.yaml` | 以 `slam_toolbox` 的預設參數為基礎 | 依 slam_toolbox 上游授權 |

如果你是上述內容的權利人，發現標示有誤，或希望移除，請開 issue 告知。
