lego1002/2026_TIRT/docs/螢幕快照 2026-07-21 22-19-02.png

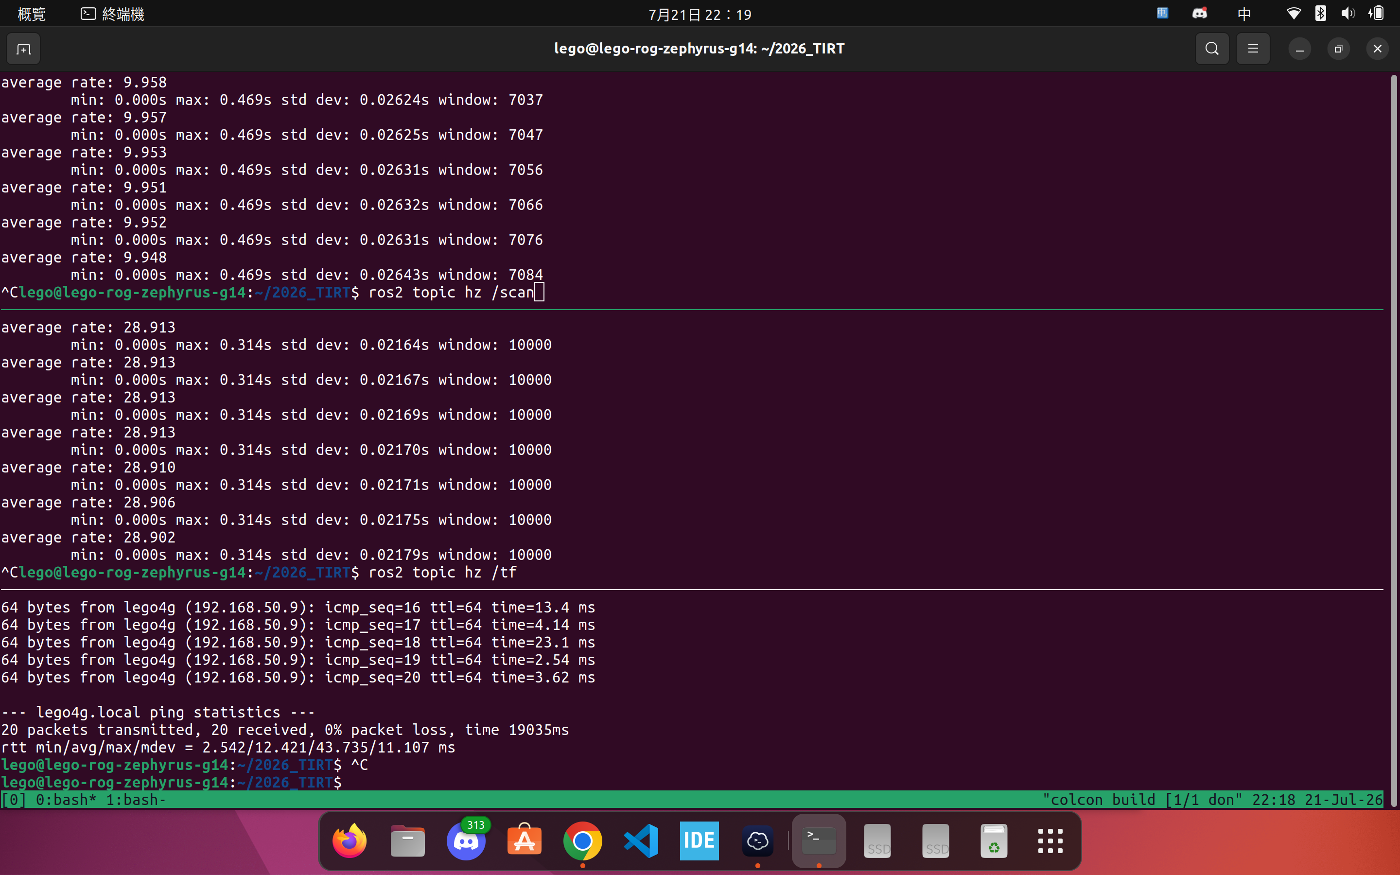
docs/螢幕快照 2026-07-21 22-19-02.png
