lego1002/2026_TIRT/docs/螢幕快照 2026-09-12 00-44-25.png

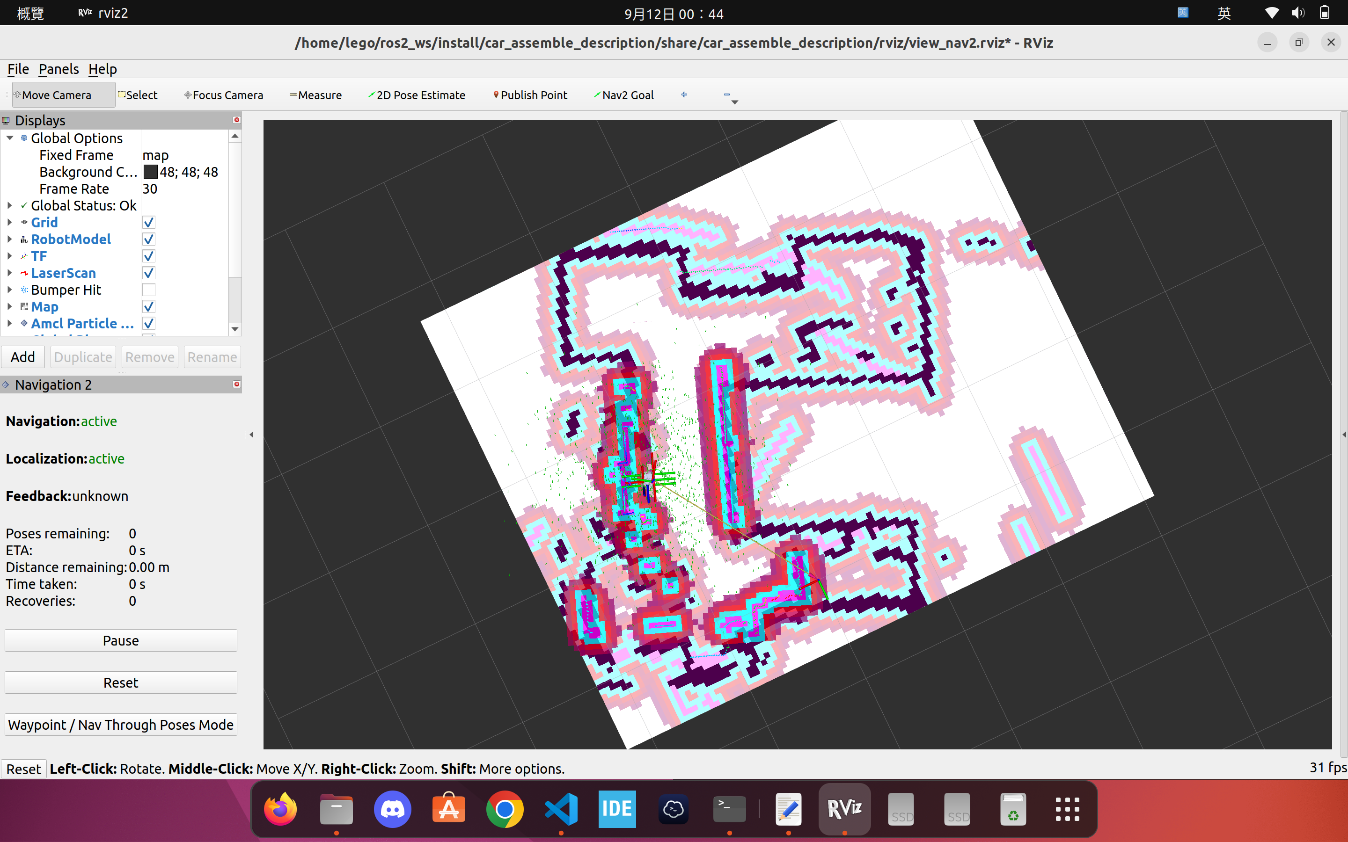
docs/螢幕快照 2026-09-12 00-44-25.png
