lego1002/2026_TIRT/docs/螢幕快照 2026-10-10 13-58-24.png

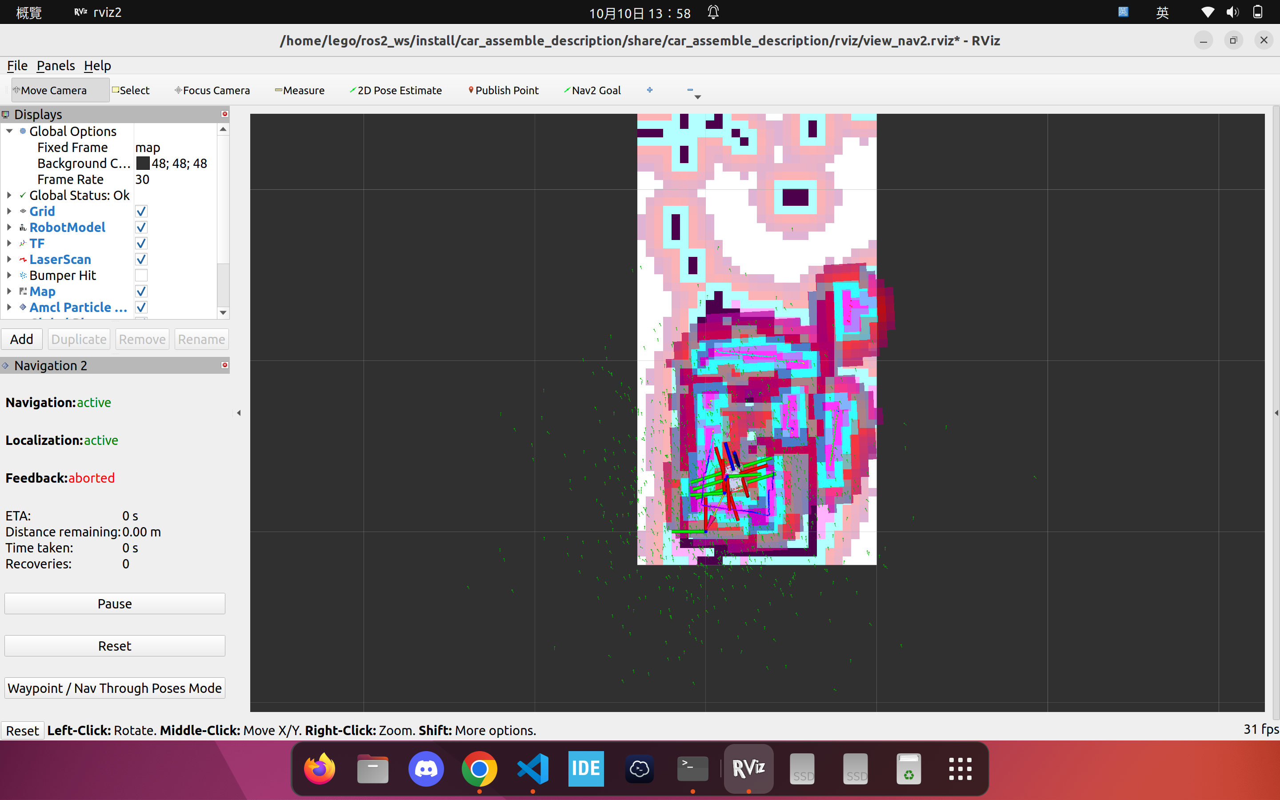
docs/螢幕快照 2026-10-10 13-58-24.png
