lego1002/2026_TIRT/docs/螢幕擷取畫面 2026-10-26 162925.png

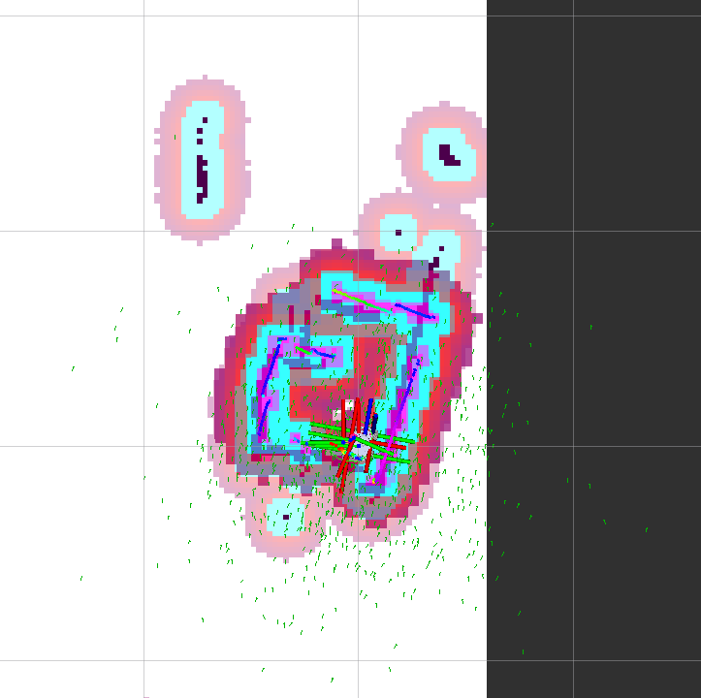
docs/螢幕擷取畫面 2026-10-26 162925.png
