lego1002/2026_TIRT/OminiBotHV-master/image/OminiBotHV.jpg

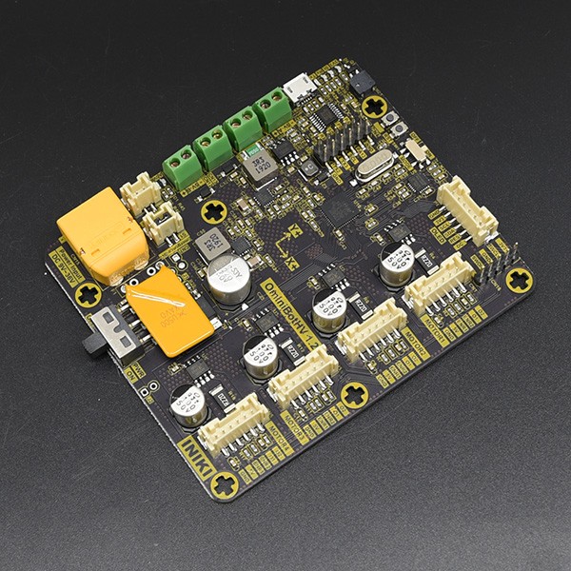
OminiBotHV-master/image/OminiBotHV.jpg
