lego1002/2026_TIRT/race_logs/2026-11-07/map/rzce_x3.png

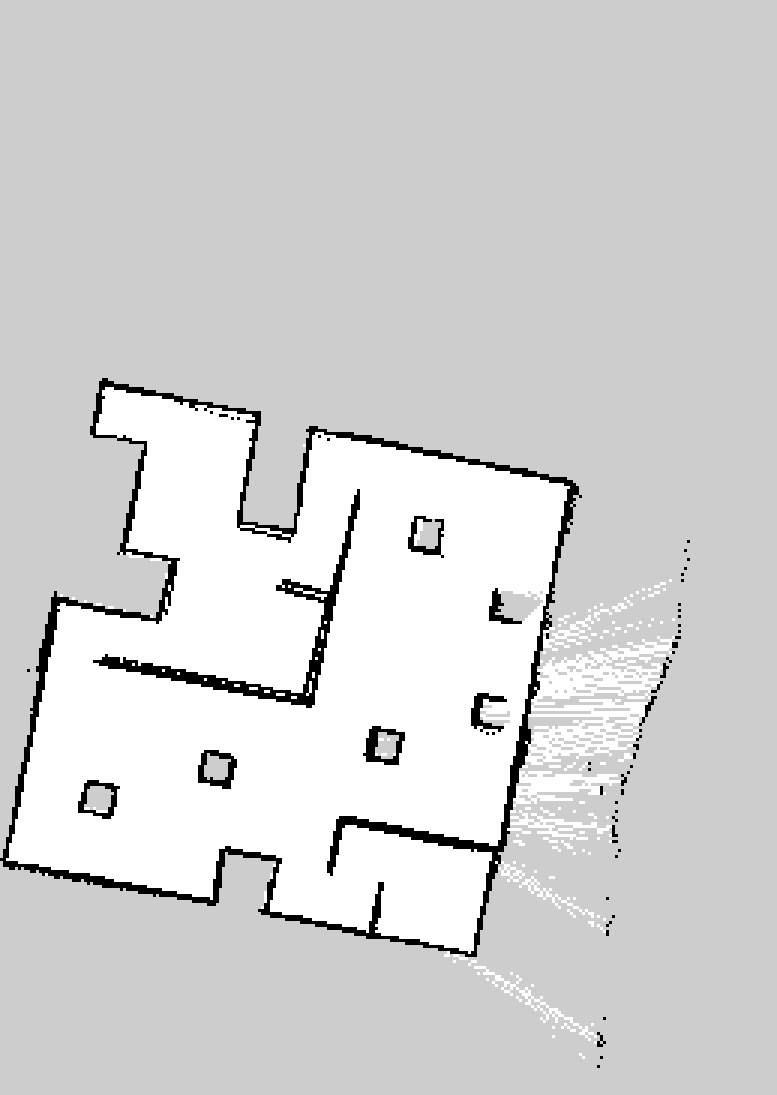
race_logs/2026-11-07/map/rzce_x3.png
