lego1002/2026_TIRT/CAD_files/step/Lego_Fram_57.stp

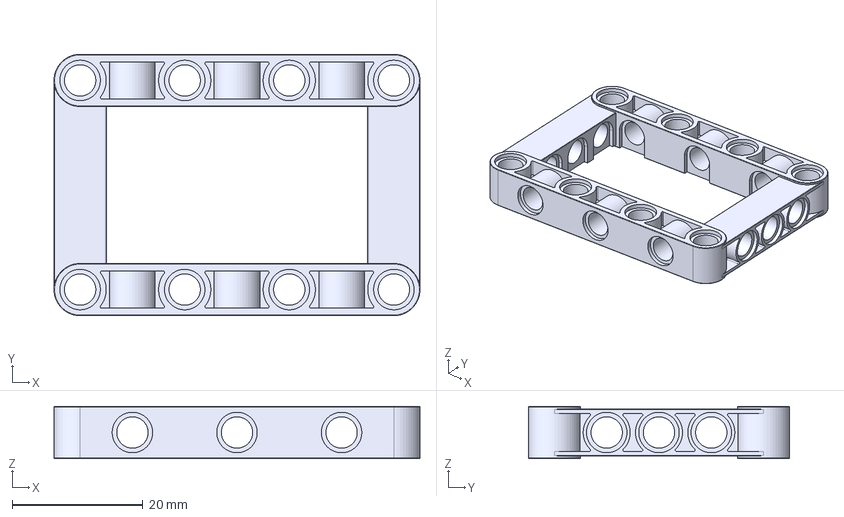
[picture p21: CAD file, 2026-06-29]
CAD_files/step/Lego_Fram_57.stp
56.0 x 40.0 x 8.00 mm
