lego1002/2026_TIRT/(list of files, cad)

Other CAD files:
CAD_files/solidworks/CAR_ASSEMBLY.SLDASM
CAD_files/solidworks/motor_wheel_bracket_ass.SLDASM
CAD_files/solidworks/Chasis_assemble_part.SLDPRT
CAD_files/solidworks/UGV_ass.SLDASM
CAD_files/solidworks/UGV_chasis_ass.SLDASM
CAD_files/solidworks/UGV_chasis.SLDASM
CAD_files/solidworks/rpi_Ominibot_ass.SLDASM
CAD_files/3DP/N20_Lego_bracket_halfup.STEP
CAD_files/solidworks/N20_Lego_bracket_halfdown.SLDPRT
CAD_files/step/Lego Technic Beam - 6898072/files/beam_12.stl
CAD_files/step/Roller_3.step.SLDPRT
CAD_files/3DP/N20_Lego_bracket_halfdown.STEP
CAD_files/step/Lego Technic Beam - 6898072/files/beam_4.stl
CAD_files/step/Side1_4.step.SLDPRT
CAD_files/3DP/omnobot_mount.STEP
CAD_files/solidworks/N20_Lego_bracket_halfup.SLDPRT
CAD_files/step/Lego Technic Beam - 6898072/files/beam_13.stl
CAD_files/step/Side 2_4.step.SLDPRT
CAD_files/3DP/omnibot_mount_right.STEP
CAD_files/solidworks/omnibot_mount_left.SLDPRT
CAD_files/step/Lego Technic Beam - 6898072/files/beams_10.stl
CAD_files/step/Roller_4.step.SLDPRT
CAD_files/3DP/test_foromnibot_mount.STEP
CAD_files/step/Lego Technic Beam - 6898072/files/beam_20.stl
CAD_files/step/Side 2_3.step.SLDPRT
CAD_files/3DP/maccanum_connector.STEP
CAD_files/step/Lego Technic Beam - 6898072/files/beam_2.stl
CAD_files/step/Side1_3.step.SLDPRT
CAD_files/3DP/rpi_lidar_plate.STEP
CAD_files/solidworks/omnibot_mount_right.SLDPRT
CAD_files/step/Lego Technic Beam - 6898072/files/beam_9.stl
CAD_files/step/Side1_1.step.SLDPRT
CAD_files/3DP/N20_Lego_bracket.STEP
CAD_files/step/Lego Technic Beam - 6898072/files/beam_17.stl
CAD_files/step/Roller_1.step.SLDPRT
CAD_files/solidworks/omnobot_mount.SLDPRT
CAD_files/step/Lego Technic Beam - 6898072/files/beam_6.stl
CAD_files/step/Side1_2.step.SLDPRT
CAD_files/solidworks/chasis_omnibot_mount.SLDPRT
CAD_files/step/Lego Technic Beam - 6898072/files/beam_11.stl
CAD_files/step/Side 2_1.step.SLDPRT
CAD_files/step/Lego Technic Beam - 6898072/files/beam_7.stl
CAD_files/step/Side 2_2.step.SLDPRT
CAD_files/solidworks/rpi_lidar_plate.SLDPRT
CAD_files/step/Lego Technic Beam - 6898072/files/beam_14.stl
CAD_files/step/Roller_2.step.SLDPRT
CAD_files/solidworks/N20_Lego_bracket.SLDPRT
CAD_files/step/Lego Technic Beam - 6898072/files/beam_18.stl
CAD_files/step/maccanum_connector.STEP
CAD_files/step/Lego Technic Beam - 6898072/files/beams_5_to_10.stl
CAD_files/step/LEGO Technic beam- 199 Dark Stone Grey v2.step
CAD_files/solidworks/RPLIDAR C1.SLDPRT
CAD_files/step/Lego Technic Beam - 6898072/files/beam_16.stl
CAD_files/step/ang_beam_L.step
CAD_files/step/Lego Technic Beam - 6898072/files/beam_3.stl
CAD_files/solidworks/omnibot_driver.SLDPRT
CAD_files/step/48mm_Mecanum_wheels.step
CAD_files/step/Lego Technic Beam - 6898072/files/beam_5.stl
CAD_files/solidworks/Lego_Technic_15_Beams.SLDPRT
CAD_files/step/Lego Technic Beam - 6898072/files/beam_15.stl
CAD_files/step/N20_with_encoder.step
CAD_files/solidworks/Lego_Technic_M_Beams.SLDPRT
CAD_files/step/Lego Technic Beam - 6898072/files/beam_19.stl
CAD_files/step/Raspberry Pi 4 Model B.STEP
CAD_files/solidworks/1500mAh_Battery.SLDPRT
CAD_files/step/Lego Technic Beam - 6898072/files/beam_8.stl
CAD_files/solidworks/maccanum_connector.SLDPRT
