lego1002/2026_TIRT/CAD_files/step/Lego Technic Beam - 6898072/README.txt

Lego Technic Beam by chriscummings100 on Thingiverse: https://www.thingiverse.com/thing:6898072

Summary:
Collection of lego beams plus supporting OpenSCAD generator with instructions on how to tune it to your printer / resin. Provided values are tuned to provide accurate/usable beams on Mars 5 Ultra with ABS Like V3 resin.
