lego1002/2026_TIRT/CAD_files/step/Lego Technic Beam - 6898072/images/beam_15.png

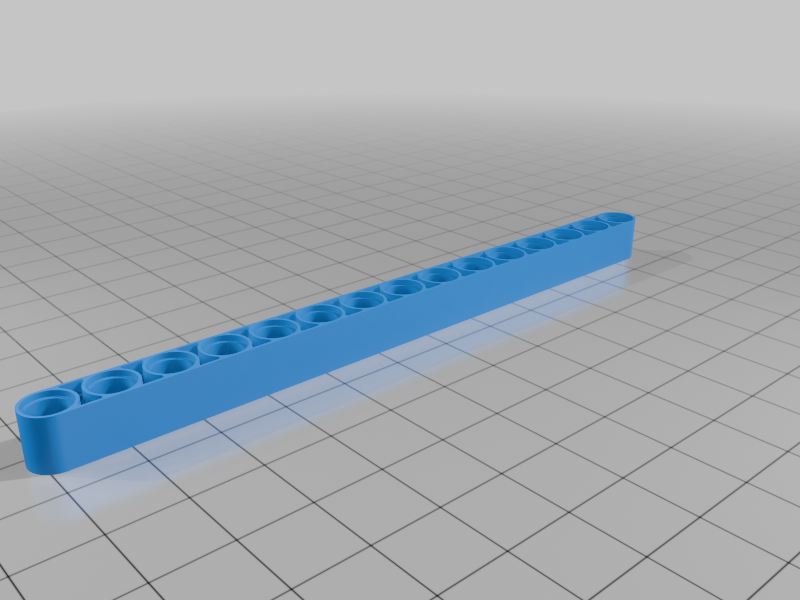
CAD_files/step/Lego Technic Beam - 6898072/images/beam_15.png
