lego1002/2026_TIRT/config/mapper_params_online_async.yaml

slam_toolbox:
  ros__parameters:

    # 核心設定
    solver_plugin: solver_plugins::CeresSolver
    ceres_linear_solver: SPARSE_NORMAL_CHOLESKY
    ceres_preconditioner: SCHUR_JACOBI
    ceres_trust_strategy: LEVENBERG_MARQUARDT
    
    # 模式設定
    mode: mapping # 建圖模式
    debug_logging: false
    throttle_scans: 1
    transform_publish_period: 0.02 # 50Hz 發布頻率
    map_update_interval: 1.0 # 2.0→1.0(2026-09-12):建圖時看得到牆即時長出來,PC 端 CPU 綽綽有餘
    resolution: 0.025 # 地圖解析度。0.05→0.025(2026-09-12):迷宮格 44 cm、牆 ~1 cm,5 cm 一格牆看起來
                      # 像積木、scan 貼不貼牆肉眼分不出來。Nav2 costmap 仍用 0.05(static layer 會重採樣),
                      # 要不要跟到 0.025 等 Nav2 實車再決定。
    max_laser_range: 12.0 # C1 最遠可以到 12m (再遠通常不準)
    min_laser_range: 0.15 # C1 最近 ~0.1m;設 0.15 濾掉太近的雜點(消除啟動時 0.0m 警告)
    minimum_time_interval: 0.1
    transform_timeout: 1.0 # 0.5→1.0:雙機 WiFi 突發傳輸實測 /scan 停頓達 0.47s,拉大等 TF 的容忍時間,避免 queue full 丟 scan
    tf_buffer_duration: 30.
    stack_size_to_use: 40000000 # 記憶體設定
    enable_interactive_mode: true

    # 座標系設定 (關鍵！)
    base_frame: base_link
    map_frame: map
    odom_frame: odom
    scan_topic: /scan

    # 機器人運動模式 (如果是差速輪/雙輪，這個很重要)
    use_scan_matching: true
    use_scan_barycenter: true
    minimum_travel_distance: 0.2
    minimum_travel_heading: 0.17
    scan_buffer_size: 10
    scan_buffer_maximum_scan_distance: 10.0
    link_match_minimum_response_fine: 0.1  
    link_scan_maximum_distance: 1.5
    loop_search_maximum_distance: 3.0
    do_loop_closing: true 
    loop_match_minimum_chain_size: 10           
    loop_match_maximum_variance_coarse: 3.0  
    loop_match_minimum_response_coarse: 0.35    
    loop_match_minimum_response_fine: 0.45

    # 關聯掃描匹配
    correlation_search_space_dimension: 0.5
    correlation_search_space_resolution: 0.01
    correlation_search_space_smear_deviation: 0.1 

    # 迴路閉合 (Loop Closure)
    loop_search_space_dimension: 8.0
    loop_search_space_resolution: 0.05
    loop_search_space_smear_deviation: 0.03

    # 掃描匹配器
    distance_variance_penalty: 0.5      
    angle_variance_penalty: 1.0    

    fine_search_angle_offset: 0.00349     
    coarse_search_angle_offset: 0.349   
    coarse_angle_resolution: 0.0349        
    minimum_angle_penalty: 0.9
    minimum_distance_penalty: 0.5
    use_response_expansion: true
