lego1002/2026_TIRT/(commit log)

2026-06-16 add cad file directory
2026-06-16 add CAD files via Git LFS and configure gitignore
    [48mm_Mecanum_wheels.step, N20_Lego_bracket.SLDPRT, N20_with_encoder.step, Raspberry Pi 4 Model B.STEP, UGV_ass.SLDASM, motor_wheel_bracket_ass.SLDASM]
2026-06-29 upload new car assembly and modify motor bracket
    [1500mAh_Battery.SLDPRT, LEGO Technic beam- 199 Dark Stone Grey v2.step, Lego_Fram_57.stp, Lego_Technic_15_Beams.SLDPRT, Lego_Technic_M_Beams.SLDPRT, N20_Lego_bracket.SLDPRT, UGV_ass.SLDASM, ang_beam_L.step]
2026-07-01 upload chasis ass and new UGV ass
    [RPLIDAR C1.SLDPRT, UGV_ass.SLDASM, UGV_chasis.SLDASM, UGV_chasis_ass.SLDASM, motor_wheel_bracket_ass.SLDASM]
2026-07-03 upload new motor bracket to put in but motor still not fixed
    [N20_Lego_bracket.SLDPRT, N20_Lego_bracket.STEP, N20_Lego_bracket_halfdown.SLDPRT, N20_Lego_bracket_halfdown.STEP, N20_Lego_bracket_halfup.SLDPRT, N20_Lego_bracket_halfup.STEP]
2026-07-07 upload rpiLidarPlate and maccanumConnector
    [maccanum_connector.SLDPRT, maccanum_connector.STEP, rpi_lidar_plate.SLDPRT, rpi_lidar_plate.STEP]
2026-07-07 want to sleep
    [UGV_ass.SLDASM, UGV_chasis_ass.SLDASM, chasis_omnibot_mount.SLDPRT, maccanum_connector.SLDPRT, maccanum_connector.STEP, motor_wheel_bracket_ass.SLDASM, omnobot_mount.SLDPRT]
2026-07-12 upload car_assemble_urdf
    [CAR_ASSEMBLE_URDF.csv, CAR_ASSEMBLE_URDF.urdf, Chasis_assemble_part.SLDPRT, N20_Lego_bracket_halfdown.SLDPRT, N20_Lego_bracket_halfdown.STEP, N20_Lego_bracket_halfup.SLDPRT, N20_Lego_bracket_halfup.STEP, Roller_1.step.SLDPRT]
2026-07-13 fixing urdf finished
    [CAR_ASSEMBLE_URDF.csv, CAR_ASSEMBLE_URDF.urdf, base_link.STL, front_left_wheel_link.STL, front_right_wheel_link.STL, lidar_link.STL, rear_left_wheel_link.STL, rear_right_wheel_link.STL]
2026-07-18 upload good motor bracket
    [CAR_ASSEMBLY.SLDASM, N20_Lego_bracket_halfdown.SLDPRT, N20_Lego_bracket_halfdown.STEP, N20_Lego_bracket_halfup.SLDPRT, N20_Lego_bracket_halfup.STEP, Roller_3.step.SLDPRT, Roller_4.step.SLDPRT, Side 2_3.step.SLDPRT]
2026-07-20 Move SLAM to PC side; gyro-heading + software odom calibration
    The Pi 4 could not keep up with async_slam_toolbox scan matching while
    also running the chassis driver, lidar, and TF -- the tf message filter
    dropped scans ("queue is full"), scan matching went open-loop on odom,
    and the map came out as rotational smear (same walls drawn at many
    angles fanning out from the start).
    Split the heavy work onto the idle PC:
    - car_assemble_description/launch/slam_pc.launch.py + run_slam.sh:
    run async_slam_toolbox on the PC. Pi streams /scan + odom TF over
    DDS; PC does scan matching and publishes map->odom + /map. Only
    small topics cross the network (the big /map is built locally on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
2026-07-25 reorganize the structure
    [CAR_ASSEMBLE_URDF.csv, CAR_ASSEMBLE_URDF.urdf, base_link.STL, front_left_wheel_link.STL, front_right_wheel_link.STL, lidar_link.STL, rear_left_wheel_link.STL, rear_right_wheel_link.STL]
2026-07-25 Stop tracking colcon build artifacts and Python caches
    build/, install/, log/ and scattered __pycache__/*.pyc were accidentally
    committed in the reorganize-structure commit; they are local-only workspace
    output that should never propagate to the Pi. Remove from tracking, add to
    .gitignore, and sync CLAUDE.md paths after the docs/ + notes/ reorg.
    [CAR_ASSEMBLE_URDF.csv, CAR_ASSEMBLE_URDF.urdf, base_link.STL, front_left_wheel_link.STL, front_right_wheel_link.STL, lidar_link.STL, rear_left_wheel_link.STL, rear_right_wheel_link.STL]
2026-07-25 upload lidar orient test
2026-07-25 Fix lidar extrinsic + DDS introspection; add chassis diagnostic tools
    The broken SLAM map is fixed. Root cause was laser_yaw sitting at 0.0 while the
    lidar is actually mounted at +167 deg (nearly backwards), so odom said "forward"
    while the lidar saw the world flow almost the other way and scan matching fought
    a near-inverted motion model on every step. Measured numerically from a rosbag
    with tools/analyze_bag.py, not by eye -- the previous perpendicular-wall check
    could not detect it, because a 180 deg error preserves the 90 deg relationship.
    Map now measures within a few cm of tape.
    Calibration values written back as launch defaults:
    laser_yaw 2.9146 rad (+167.0 deg, from a str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
    [analyze_bag.py, driver_node.py, map_check.py, odom_check.py, record_diag.py, robot_bringup.launch.py, selftest_analyze.py, step_response.py]
2026-07-27 Rework startup: fixed alias IPs, remote tmux control, one-command GCS
    Operator flow was: ssh into the Pi for ./run_robot.sh, then four laptop
    terminals, each needing DDS_SERVER=<pi_ip> looked up by hand after every
    network change. Now it is `./gcs.sh` on the laptop and nothing on the Pi.
    Networking (net/): both machines additionally hold a fixed alias IP
    (Pi 10.77.0.2 / PC 10.77.0.1) on top of DHCP, so the ssh target and the DDS
    discovery-server address are constants that survive any venue change. mDNS
    was rejected for this: it travels by multicast, which the venue AP was
    proven to block on 2026-07-24. netplan lists every venue's access-points at
    once so wpa_supplicant auto-joins whichever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
    [cmd_vel_check.py, driver_node.py, motor_diag.py, ominibot_hv.py, robot_bringup.launch.py, slam_pc.launch.py, teleop_node.py]
2026-07-27 Keep failures visible instead of letting windows vanish
    remain-on-exit on both tmux sessions: a window whose process dies used to
    disappear, taking its error message with it, and if it was the only window
    the whole session went with it -- the observable symptom was 'I ran gcs.sh
    and nothing happened', with nothing to look at. Dead panes now stay, and
    robot_tmux respawns them on the next up/restart (send-keys is a no-op on a
    dead pane, so this needed handling explicitly).
    gcs.sh: nested tmux made 'exec tmux attach' fail and the script silently
    vanish; use switch-client when $TMUX is set. Also verify the session
    actually got created rather than pressing on.
    run_discovery_server.sh: drop 'set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
2026-07-27 robot_tmux: up exited 1 on success, silently killing gcs.sh
    Two bugs, both invisible from the outside.
    1. cmd_up's loop ended with `[ "$w" = dds ] && sleep 1.5`. For every window
    that is not dds that test is false, so the compound returns 1 -- and being
    the loop's last command it became cmd_up's status, the script's status, the
    ssh status, and robotctl's status. gcs.sh's `robotctl up || exit 1` then
    exited before creating the laptop session, so SLAM and RViz never started
    while the Pi came up perfectly. No error was printed anywhere, which is why
    this took three rounds to find. Use `if` and return 0 explicitly.
    2. win_busy trusted pane_current_command, which is the tty fo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
2026-07-28 Add Nav2 autonomous navigation (PC-side, holonomic, saved-map)
    `./run_nav2.sh [map]` is the alternative to `./run_slam.sh` — SLAM builds a
    map, Nav2 drives on a finished one. Both publish map->odom, so the script
    pkills a stale slam_toolbox (and nav2_container) before starting.
    nav2_pc.launch.py is a thin wrapper over nav2_bringup's bringup_launch.py
    (slam:=False → AMCL against a saved map) plus RViz. `map:` has no default and
    must be absolute: maps stay in the repo's maps/, outside the package share, so
    saving a new one needs no colcon build.
    Everything custom is in config/nav2_params.yaml. Four groups of changes vs the
    stock nav2_bringup file, all of them required:
    - use_sim_time f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
2026-07-28 Consolidate all tunable YAML into /config; raise Nav2 speed
    Config consolidation (operator request): nav2_params.yaml,
    mapper_params_online_async.yaml and the dead ROS 1 joint_names file now all
    live in the repo-root config/, and car_assemble_description has no config/ of
    its own. Params are what actually gets edited between field runs, like maps/,
    so they shouldn't be buried inside a package. CMakeLists installs ../config/
    into the package share, so launch files keep resolving params through
    get_package_share_directory() with no knowledge of where the repo is, and
    --symlink-install still means no rebuild after editing (a node restart is
    still needed — these are read at configure time). Tr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
2026-07-28 gcs.sh: add --nav mode so Nav2 is also a one-command startup
    `./gcs.sh --nav [map]` replaces the `slam` window with a `nav` window running
    run_nav2.sh. It is a mode, not an addition: SLAM and Nav2's AMCL both publish
    map->odom, and slam_toolbox's live /map fights map_server's saved one. It also
    omits teleop from `robotctl up` and shuts a running one down — teleop_node
    streams zeros at 20 Hz to feed the driver watchdog and would fight Nav2 for
    /cmd_vel. Switching modes is --down then --nav; there is deliberately no
    in-place switch, since a half-torn-down stack is how you end up with two
    map->odom publishers.
    Bare non-`k:=v` args are now read as a map name, so `./gcs.sh 201_self_test`
    gives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
2026-07-28 run_*.sh: reject flags with a useful message instead of a ros2 usage dump
    `./run_robot.sh --nav` on the Pi produced "ros2: error: unrecognized
    arguments: --nav" — correct but unhelpful, since these scripts forward their
    args straight to `ros2 launch` and only take k:=v. --nav is especially easy to
    mistake for a global flag; it belongs to gcs.sh, on the laptop, and Nav2 runs
    on the PC rather than the Pi.
    This was worse than a bad message: run_robot.sh pkills the running bringup and
    `fuser -k`s the GPIO UART *before* it reaches `ros2 launch`, so a mistyped flag
    killed the live robot and then failed. The guard runs before any of that, so
    the destructive half can no longer execute on a bad ar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
2026-07-28 run_nav2.sh: auto-copy a missing map from the Pi
    `/maps` is gitignored, so maps never sync between the machines — and the
    natural workflow puts them on the wrong one: save_map.sh writes to whichever
    machine you run it on, the operator saves from the Pi, but map_server runs on
    the PC. Result on the laptop: "找不到地圖 maps/201_self_test.yaml" listing a
    different set of maps than the Pi has, with nothing pointing at why.
    run_nav2.sh now scp's a missing map from the Pi (both .yaml and .pgm). It only
    acts when the file is absent locally, so it cannot clobber anything, it is
    read-only on the Pi, and it is skipped when the local machine holds the Pi's
    alias IP (i.e. when running on the Pi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
2026-07-28 Track maps/ in version control
    /maps was gitignored, so the two machines' maps/ directories genuinely diverged
    and the natural workflow (save on the Pi, navigate on the PC) always put the
    map on the wrong machine. The .pgm files are binary but tiny — 68 KB for all
    four maps — which is a good trade for keeping both machines in sync and having
    the competition map backed up somewhere other than the Pi's SD card.
    No .gitattributes/LFS rule is added: these are far too small to be worth it,
    and LFS would mean the maps silently become pointer stubs on any clone made
    without git-lfs installed — the opposite of the goal here.
    run_nav2.sh's scp fallback stays useful for a map saved but not yet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
2026-07-28 Fix goal-aborts-instantly: robot_radius 0.11 -> 0.09, add tools/costmap_check.py
    Diagnosed from the Pi against the live laptop-side Nav2. Idle Nav2 logged zero
    warnings and map->base_link resolved, so the link and localization were fine —
    the failure was purely costmap geometry:
    The robot's own cell was INSCRIBED_INFLATED_OBSTACLE, i.e. there was no legal
    *start* pose, so the planner never began and every goal aborted immediately with
    nothing logged. Worse, robot_radius 0.11 cut the whole maze into disconnected
    pockets. Measured on 201_self_test by re-inflating the raw /map:
    robot_radius 0.12 -> largest connected region 3.74 m²
    robot_radius 0.11 -> largest connected region 4.07 m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
2026-07-28 Scan/map misalignment: add tools/scan_match_check.py, tighten AMCL update thresholds
    Measured the "point cloud doesn't line up with the map" symptom from the Pi
    against the live laptop Nav2, rather than eyeballing it:
    current pose : mean distance-to-nearest-wall 0.039 m
    best-fit pose : 0.017 m, requiring dx=0.00 dy=0.00 dyaw=+8..10 deg
    So the map is sound (best fit well inside one 0.05 m cell) and the error is pure
    rotation in the localization. 8 deg is 3*sin(8deg) ~ 0.42 m at 3 m range, which
    is exactly why near walls look aligned while far walls are visibly rotated.
    That magnitude matched update_min_a (0.15 rad ~ 8.6 deg) closely enough not to
    be a coincidence: AMCL does not correc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
    [scan_match_check.py]
2026-08-02 Add 2D sim, mission runner, and humble->jazzy Nav2 params compat
    sim/: an ament_python package (tirt_sim) that is interface-identical to the
    real robot -- fake_base replaces ominibot_driver, fake_lidar replaces
    sllidar_node -- so run_slam.sh, run_nav2.sh, save_map.sh, mecanum_teleop and
    both RViz configs run against it unmodified. Deliberately fake 2D physics:
    only the effects that change upper-layer behaviour are modelled (accel limits,
    odom scale error, slip, cmd dropout, lidar noise). sim/faults.md reproduces
    eight bugs that actually happened on this robot, each with symptom, diagnosis
    command and the tools/ script that proves it.
    tools/run_mission.py: competition mission runner. Rule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
    [nav2_params_compat.py, run_mission.py]
2026-09-11 robot_tmux.sh: SIGINT-then-wait teardown so sllidar_node stops its motor
    tmux kill-window/kill-session send SIGHUP and sllidar_node only handles
    SIGINT; its setMotorSpeed(0)+stop() run after work_loop() returns, so the
    lidar kept spinning after ./gcs.sh --down. down/down <win>/restart now
    interrupt_win + wait_idle first, and the pkill backstop is -INT then TERM.
    Claude-Session: https://claude.ai/code/session_019iZHfNWrgED96zXCxFEWnp
2026-09-11 Nav2: drop RotateToGoal gate, yaw tolerance 3.15, Dijkstra, BaseObstacle 0.5
    2026-08-15 tuning for 'too slow / stalls at the goal / odd paths', not yet
    hardware-verified; rationale and change log in notes/nav2_tuning.md §9.
    Costmap resolution stays 0.05 while the SLAM map moves to 0.025.
    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
2026-09-11 Add oled_status node + tirt-oled boot service for the on-robot SPI OLED
    Shows alias IP, pack voltage/charge bar, body velocity and scan/odom
    arrival rates. Reads the pack voltage straight off /dev/serial0 (read-only,
    no init frames) while no driver owns the port. pi/install_oled_service.sh
    installs a systemd unit so the panel lights at boot with no laptop.
    tools/oled_test.py is the ROS-free bring-up test.
    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
2026-09-11 Driver: sync commands to feedback frames (kills the desync beat), gyro bias, odom gap handling
    Scan-vs-map misalignment right after the first drive traced to a beat
    between the driver's 20 Hz command timer and the board's 20 Hz feedback:
    a write landing mid-transmit truncates that frame, so every ~100 s all
    frames collided for 5-10 s (up to 90.7% bad, bcc=0, kernel uart overrun=0),
    the gap between odom samples exceeded the hard-coded 0.5 s cap and that
    motion was discarded while the robot kept moving.
    - cmd_sync_to_feedback (default true): the read thread writes the command
    right after each good feedback frame; the cmd_rate timer is a fallback.
    Verified idle: 200 /odom msgs per 10 s, ma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
    [driver_node.py, mapper_params_online_async.yaml, ominibot_hv.py, robot_bringup.launch.py]
2026-10-26 Calibrate cmd scale (6.54/7.43), retune Nav2 for real speeds, nav run recorder
    - tools/vel_sweep.py + tools/apply_calibration.py: measure cmd_vel scale and
    apply it everywhere it is coupled (incl. dropping the min_speed workaround)
    - config/nav2_params.yaml + notes/nav2_tuning.md: retuned after calibration;
    2026-10-10 nav runs and debrief
    - teleop defaults 0.6/1.5 -> 0.2/0.8 now that cmd is calibrated
    - tools/nav_record.py + notes/nav_runs/: recorded Nav2 runs
2026-10-26 Single-machine mode: everything on the Pi, driven from ./menu.sh
    The operator only has Windows + MobaXterm, and the rules forbid remote
    compute, so mapping, Nav2 and RViz (X-forwarded) now all run on the Pi.
    - menu.sh: numbered menu for mapping / teleop / save map / nav / RViz /
    health check / logs / shutdown; switches mapping<->nav in place
    - ~/.tirt_solo flag -> dds/fastdds_solo.xml + ROS_LOCALHOST_ONLY=1; no
    discovery server or alias IP needed (battery-only boot works).
    maxInitialPeersRange 64: the default 4 left /odom undiscovered
    - robot_tmux.sh: slam/nav/rviz windows, `busy` subcommand, SIGKILL the
    nav2 container after stopping nav (it was orphaned at load 5.5)
    - oled_boot.sh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
2026-10-26 menu: option 9 settles AMCL in place via request_nomotion_update (tools/amcl_settle.py)
    AMCL only updates on motion, so after 2D Pose Estimate a parked robot's
    particle cloud never converges. The tool asks for no-motion updates and
    prints AMCL's own std-dev until it is under 5 cm / 5 deg.
2026-10-26 Nav2: controller 20->10 Hz, DWB 1440->480 samples, local costmap 10->5 Hz for on-Pi runs
    With everything on the Pi the controller logged 'Control loop missed its
    desired rate of 20Hz' continuously (load 9 on 4 cores, 81 C), then
    'Failed to make progress'. Total controller compute is now ~1/6.
2026-10-26 Solo DDS: drop unicast initial peers (36-85 s discovery); fix menu health check and throttle labels
    - fastdds_solo.xml is now an empty default profile + ROS_LOCALHOST_ONLY=1.
    Unicast initial peers made a fresh process need 36-85 s to see 8 nodes
    (default multicast on lo: first try, ~3 s), so ros2 CLI was flaky:
    half-empty topic list, 'Node not found', health check showing no /odom.
    - tools/health_check.py measures /scan, /odom and battery in one node;
    backgrounded 'ros2 topic hz' + timeout -s INT was unreliable in the menu.
    - power label decodes get_throttled bits: 0x80000 is over-temperature,
    not under-voltage.
2026-10-26 Motor PWM cap 3600->7056 (top speed 0.23->0.44 m/s); Nav2 max_vel_x 0.35
    The factory motor_pwm_max 3600 is 50% duty, which held the 12V 200rpm N20s
    to a flat 0.232 m/s for any command >=0.3, on the floor and in the air.
    At 98% duty the base tracks commands up to 0.40 and tops out ~0.44 m/s.
    Nav2 FollowPath/velocity_smoother raised to 0.35 with max_speed_xy 0.35 so
    combined x+y motion stays under the wheel-speed ceiling.
2026-11-01 net: cable-direct ssh rescue (eth0 static 10.78.0.2), shown on the OLED
    A laptop-to-Pi cable has no DHCP server, so eth0 sat in "configuring"
    with only an IPv6 link-local address. net/70-tirt-eth.yaml adds a static
    10.78.0.2/24 alongside cloud-init's dhcp4 (netplan merges them), installed
    with netplan try via net/install_pi_eth.sh. The OLED adds a "LAN <ip>"
    page while a cable is plugged in and shows it on the no-wifi rescue page.
    Claude-Session: https://claude.ai/code/session_01PpPZoxiSw4xgX9DAK1gYgn
2026-11-02 Laptop RViz mode (menu l), adjustable nav safety radius (menu r), loc_status marker
    - menu l: ~/.tirt_laptop_rviz -> DDS role solo_net (all nodes stay on the Pi,
    Discovery Server on 127.0.0.1, whitelist lo/10.77.0.2/10.78.0.2) so an Ubuntu
    laptop can run RViz itself; ./run_rviz.sh [nav] on the laptop, fastdds_pc_eth.xml
    for the cable link.
    - menu r: competition 0.09/0.18 vs room 0.07/0.12 costmap radius, applied by run_nav2.sh.
    - loc_status node: AMCL covariance -> READY/ALMOST/NOT LOCALIZED text above the robot.
    - maps/room_1101.
2026-11-07 race: archive 2026-11-07 logs and add troubleshooting guide
    Keep the operator's commands, the ROS logs, the parameters actually loaded
    and the race map, so the failed navigation runs can be analysed later. The
    root cause is still open: pose and cmd_vel were not recorded.
    Network identifiers and the lidar serial number are masked because this
    repository is public.
2026-11-07 teleop: ramp key commands, and keep the race map
    A key press asked for full speed within one 50 ms message, the suspected
    trigger for wheel slip that /odom cannot see. This version ran at the race
    on 2026-11-07, together with the rzce map saved there.
2026-11-07 docs: add project README and record the race oscillation
    Give the repo an entry point and a notes index, gather stray notes and test
    logs under notes/, and add CI for the checks that need no hardware. Scripts
    and packages stay where they are because the menu and the robot depend on
    those paths.
    The operator recalled that the robot moved left and right instead of
    spinning its wheels, so the race record now leads with controller and
    localization suspects. The cause is still unproven.
2026-11-07 license: adopt BSD-3-Clause for the project's own work
    The packages already declared BSD, but the repo had no license file, so others
    had no clear permission to reuse the code. Vendor files, the rulebook and
    third-party CAD are listed separately because this project cannot relicense
    them; the vendor example has no stated license at all.
